HemangGadhvi04/48v-microgrid/hardware/results/magnetics_thermal_report.md

# Magnetics Winding and Thermal Screen

This analytical screen sizes conductor count from both current-density and DCR requirements. The stacked-core window scales with stack count and a 70% round-wire packing factor is applied. Release still requires the exact bobbin drawing, a wound sample, measured DCR, loaded inductance, and a thermal test.

| Inductor | Cores | Turns | Strands (current / DCR / selected) | Est. DCR / limit | Effective fill | Est. loss | Est. rise | Screen |
|---|---:|---:|---:|---:|---:|---:|---:|---|
| LDC | 3 | 28 | 20 / 52 / 52 | 14.87 / 15.00 mOhm | 33.1% | 3.48 W | 9.3 C | PASS |
| L1 | 2 | 19 | 23 / 34 / 34 | 11.85 / 12.00 mOhm | 22.0% | 3.75 W | 12.0 C | PASS |
| L2 | 1 | 19 | 23 / 24 / 24 | 11.70 / 12.00 mOhm | 31.1% | 3.61 W | 15.0 C | PASS |

## Result

**PRELIMINARY PASS:** the revised conductor counts satisfy the analytical DCR, effective-fill, and temperature-rise screens.
