HemangGadhvi04/48v-microgrid/docs/PROJECT_EXECUTION_STATUS.md

# Project Execution Status

Status date: 2026-09-11

Completion percentages represent verified deliverables, not elapsed calendar
time. Hardware stages carry more uncertainty than simulation and remain open
until bench evidence exists.

| Phase | Verified completion | Evidence complete | Remaining gate |
|---|---:|---|---|
| 1. Simulation foundation | 95% | All eight regression stages pass; report and plots retained | Repository release and publication |
| 2. Power electronics hardware | 60% | Testbench requirements, portable control/protection, integrated real-time application, corner/loss and sensing calculations, complete current/voltage/temperature front-end connectivity and calculated ADC ranges, manufacturer-curve-based E65 magnetic stack/turn/conductor sizing, tolerance-safe 30 mF DC-link bank, exact passive/fuse/connector candidates, contactor families, calculated bootstrap and independent PWM-disable chain, four-layer PCB current/spacing constraints, expanded BOM, reproducible KiCad capture covering 156 symbols/502 pins/132 logical nets, frozen LaunchPad allocation, host-tested ISR boundary, explicit ADC/PWM timing configuration, CPU1 peripheral initialization, and Driverlib adapter | KiCad native ERC, production symbols and footprint refinement, exact bobbin/physical magnetic validation, PCB layout, target build and timing, assembly and 500 W bench test |
| 3. Battery and grid interface | 55% | Bidirectional battery ECM, dynamic-phasor transition validation, dual-PLL application integration, grid-following/grid-forming transfer, portable droop, relay synchronization, and dual-side voltage measurement requirements | Cell characterization/BMS, switching and HIL transfer tests, grid emulator and measured transitions |
| 4. Communications and SCADA | 78% | SunSpec 1/101 schema, matching embedded C and Python endpoints, bounded 3.5-character RTU framer, coherent ISR telemetry snapshots, C2000 SCI-B/RS-485 direction binding, durable gateway, InfluxDB writer, Grafana dashboard and host tests | Target build, physical commissioning, live services, endurance/fault testing and independent conformance checks |

Approximate overall execution is now about 65%. About 35% remains, with
most remaining effort in physical design, procurement, assembly, commissioning,
and safety-controlled bench validation.

## Current verified baseline

- The MATLAB regression suite passes open-loop and closed-loop islanded
  inverter tests, LCL/grid tests, SOGI-PLL tests, grid-following tests, PV and
  MPPT tests, and the coupled solar-to-grid energy-balance test.
- The portable C firmware core builds with C11 warnings treated as errors.
- Host tests verify PI anti-windup, P&O convergence, buck/boost duty bounds,
  safe startup and precharge, latched protection, SOGI-PLL tracking through a
  50 Hz to 52 Hz step, PR current control against an RL plant, utility-loss
  transfer to grid-forming PWM, breaker isolation, synchronization, and
  qualified reconnection.
- The C2000 configuration now freezes and checks a 100 MHz ePWM clock,
  center-aligned 20 kHz `TBPRD=2500`, 100 ns/10-count dead band, three-module
  eight-channel ADC SOC schedule, 200 ns acquisition windows, and a calculated
  1.68 us coherent conversion-set time. Physical target timing remains open.
- Manufacturer curve fits now give electrically feasible 40-permeability Kool
  Mu HF E65 references: 3 cores/28 turns for LDC, 2/19 for L1, and 1/19 for L2,
  all at or below 0.199 T predicted peak flux. Window and thermal proof remain
  open before these become released winding designs.
- Three KEMET ALS31A103KE100 capacitors now form the reference DC-link bank.
  Even at -20% tolerance it provides 24 mF, predicts 1.23 V peak-to-peak ripple,
  and has 4.6 times the calculated 100 Hz ripple-current requirement. The
  30 mF value passes the complete eight-stage MATLAB simulation regression.
- The gate-drive chain now uses the UCC27211A internal bootstrap diode, a
  checked 100 nF capacitor, and a discrete four-term safety enable applied to
  all eight PWM inputs. Conservative margins are 1.75 V above bootstrap UVLO,
  83 ns effective dead time, and 85 ns maximum asynchronous disable latency.
- A native KiCad project now captures every row of the checked connectivity
  model with embedded project symbols. Its deterministic generator and
  independent verifier prove exact coverage; KiCad's own ERC remains pending
  until the local tool installation completes.
- U6-U8 are frozen to TMCS1123B2AQDVGRQ1. The 30 A hardware threshold uses a
  0.600 V VOC setting; calculated sensor-conductor loss is 0.210 W worst case.
  The source schematic now includes VS, GND, VREF, VOC, OC, ALERT and NC pins,
  threshold dividers, 10 uF threshold stabilization, and local supply bypassing.
- PV and DC-bus sensing now use calculated OPA320-Q1 live-zero divider stages;
  PCC and utility sensing use AMC3330-Q1 isolated amplifiers with OPA320-Q1
  ADC drivers; heatsink temperature uses TMP235-Q1. All eight nominal ADC
  ranges pass the 0.1 V to 3.2 V design-margin test.
- The PCB baseline is four layers with 70 micrometre outer copper, 12 mm DC and
  6 mm AC power paths, explicit analog/switch-node separation, and no reliance
  on vias as the primary high-current path.

## Immediate execution sequence

The project has transitioned to a rigorous 10-Gate hardware transition framework. The immediate next steps are:

1. **Gate 1B-1D (Pending User Action):** Perform physical target compilation in TI Code Composer Studio (CCS), flash the F28379D LaunchPad, and verify deterministic ADC/PWM/ISR timing and hardware Trip Zone functionality via oscilloscope.
2. **Gate 2 (Magnetics Redesign):** Redesign the E65 Kool Mµ inductors (more parallel strands, larger cores, or different topology) to resolve the DCR limit failures (LDC currently 38.67 mΩ > 15 mΩ).
3. **Gate 2 (Electrical Design):** Complete the semiconductor loss models, select final unresolved analog frontend ICs (buffers/isolation amplifiers), and freeze the Gate 2 electrical schematic.
4. **Gate 3-10:** Proceed sequentially through PCB layout, low-voltage bring-up, and staged power testing up to 500 W.
