HemangGadhvi04/48v-microgrid/docs/IMPLEMENTATION_PLAN_10_GATES.md

# Complete 48V Microgrid Execution Plan (Revised 10-Gate System)

This plan details the sequence of engineering gates to close the remaining 38% of the project. It introduces strict milestones to minimize risk, transitioning the validated mathematical models and generated schematics into a physical, tested 500W prototype.

## User Review Required

> [!WARNING]
> **Toolchain & Licensing:** We will need access to a KiCad 8.x installation for PCB layout and Texas Instruments Code Composer Studio (CCS) with C2000Ware for physical firmware compilation.
> 
> **Hardware Lab Safety:** Stage 6 involves live 48V DC and AC mains-equivalent test voltages. Safe bench procedures, current-limited lab supplies, and a grid emulator / programmable AC source are mandatory for physical execution.
>
> **Formal Professor Reviews:** 
> 1. Pre-Fabrication (Gate 4)
> 2. Pre-Power (Gate 6)
> 3. Pre-Grid Emulator (Gate 7)

## Open Questions

> [!IMPORTANT]
> 1. **Hardware Sourcing:** Are we sending the PCB out for PCBA (assembly) or assembling the prototype in-house? This changes how we output manufacturing files.
> 2. **Grid Emulator:** Do we have access to a physical AC grid emulator/source for Phase 3 testing, or will we rely on resistive/RL dummy loads for initial inverter validation?

## Gate Execution Sequence

### Gate 0 — Freeze the Hardware/Firmware Contract
- [x] Create `docs/hardware_firmware_interface.md`
- [x] Freeze PWM, ADC, GPIO mapping and polarities

### Gate 1 — Real C2000 Target Build
- **1A. Toolchain**: Setup `c2000_port` modular file structure.
- **1B. Bring-up firmware**: Skeletal implementation testing clock → GPIO → PWM → ADC → ISR → TZ → SCI.
- **1C. ISR Profiling**: Measure execution time (Budget < 35 μs).
- **1D. Hardware shutdown path**: Time sensor → comparator → trip → ePWM disable chain physically.

### Gate 2 — Final Electrical Design
- **2A. Power architecture**: Document worst-case maximums and transients.
- **2B. Semiconductor review**: Conduction/switching loss tables for FETs.
- **2C. Gate-drive review**: CMTI, isolation, dead-time margins, bootstrap behavior.
- **2D. Sensor design**: Analog filter and ADC scaling design.
- **2E. Protection architecture**: Centralized fault matrix.
- **2F. Magnetics**: Thermal and window fill calculation verification.

### Gate 3 — PCB Design
- **Stackup**: Define KiCad net classes, trace widths (based on IPC-2152), and 4-layer allocations.
- **Critical Loops**: Isolate high di/dt and switch nodes from TMCS1123 sensing zones.

### Gate 4 — Pre-Fabrication Design Review (PROFESSOR CHECK 1)
- **Review**: Schematic ERC, PCB DRC, footprints, orientation.
- **Deliverable**: Generate Fab package (Gerbers, BOM, etc.).

### Gate 5 — Board Bring-Up
- **5A. Unpowered inspection**: Resistance checks to ground on all rails.
- **5B. Control power only**: 15V, 5V, 3.3V bias verification.
- **5C. PWM without power**: Validate dead-time via oscilloscope.

### Gate 6 — Progressive Power Testing (PROFESSOR CHECK 2)
- **6A. DC/DC First**: 0 to 500W open loop to closed loop tests. Validate thermal limits.
- **6B. Inverter Standalone**: Islanded voltage control into resistive load up to 500W. 250→500W load step validation.

### Gate 7 — Physical Grid Interface (PROFESSOR CHECK 3)
- **7A. PLL test**: Lock and tracking to grid emulator (49Hz - 51Hz sweep).
- **7B. Breaker synchronization**: Zero-power phase-match closing test.
- **7C. Grid-following**: 0W to 500W physical export.

### Gate 8 — Microgrid Intelligence
- **State transitions**: Verify seamless Grid-following → Grid-forming behavior upon grid loss. 

### Gate 9 — Communications and Telemetry
- **Gateway**: Run Python gateway against the physical target RS-485 via SCI-B.
- **24-hour Soak**: Monitor for fault flags, CRC errors, and thermal drift over a continuous 24h run.

### Gate 10 — Final Verification and Release
- Create the final benchmark matrix mapping Simulation vs Hardware vs Difference.
- Complete documentation and repository release.
