HemangGadhvi04/48v-microgrid/docs/archive/conversation_backup.md

# Complete Conversation Backup Archive

## 1. Full Project Overview

### Main Objective

Build a **48V Open-Source Microgrid Research Platform** at approximately **500W scale**, suitable for lab-bench research and portfolio development.

### Core Purpose

To help Hemang, a BTech student in **Sustainable Energy Technologies**, develop industry-relevant skills in:

* grid-interactive inverter design
* grid-code compliance
* power electronics
* PLL synchronization
* LCL filter design
* PV modeling
* battery-grid integration
* droop control
* islanding/seamless transfer
* SunSpec Modbus communication
* dashboard-based monitoring

The uploaded roadmap frames this as a project focused on **Grid Code Compliance**, described as a valuable skill for companies such as Sterling & Wilson, Tata Power Solar, Fluence, GE Vernova, and Delta Electronics. 

### Original Problem

Hemang asked for a **step-by-step approach** to build the project.

### Evolution of Discussion

The conversation evolved as follows:

1. User shared the project concept.
2. Assistant converted the concept into a practical phased execution roadmap.
3. User agreed and asked to continue.
4. Assistant created a detailed **3-month weekly plan**.
5. User now requests a complete backup/archive of the whole conversation.

### Current Status

The project is currently at the **planning and roadmap stage**. No actual simulation, code, hardware design, or testing has been completed in the conversation.

---

# 2. Complete Timeline

## Stage 1: Project Introduced

User stated:

* “I want to build this project.”
* Identified himself as **Hemang**.
* Mentioned he is doing **BTech in Sustainable Energy Technologies**.
* Asked for a step-by-step approach.

## Stage 2: Uploaded Project Roadmap

The uploaded text described:

* Project title: **The 48V Open-Source Microgrid Research Platform**
* Scale: **500W**
* Value proposition: **Grid Code Compliance**
* Four phases:

  * Simulation-only foundation
  * Power electronics hardware
  * Battery and grid interface
  * Communication layer

## Stage 3: First Assistant Response

Assistant converted the roadmap into a practical execution approach:

* Start with simulation.
* Avoid hardware first.
* Build inverter simulation.
* Add LC and then LCL filter.
* Implement PLL.
* Model PV using single diode model.
* Move later to C2000, GaN/SiC, PCB, battery, droop control, and Modbus.

## Stage 4: User Asked to Continue

User replied: “yup go on.”

## Stage 5: Second Assistant Response

Assistant produced a **3-month weekly execution plan**, covering:

* Month 1: fundamentals and inverter simulation
* Month 2: grid connection, LCL filter, PLL
* Month 3: PV model, MPPT, full solar-grid simulation, documentation

## Stage 6: Current Request

User asked for a complete archive of the conversation.

---

# 3. All Ideas

## Accepted Ideas

These were treated as core project directions:

* Build a **48V, 500W microgrid research platform**.
* Begin with **simulation only**.
* Use **MATLAB/Simulink + Simscape Electrical**.
* Model a **single-phase grid-following inverter**.
* Design and compare **LC and LCL filters**.
* Implement a **PLL**.
* Create a **single-diode PV model manually**.
* Use GitHub for documentation.
* Later use **TI C2000 LaunchPad TMS320F28379D**.
* Use **GaN or SiC devices** for advanced hardware.
* Design a proper PCB instead of jumper wiring.
* Implement **droop control**.
* Study **seamless transfer/islanding detection**.
* Add **SunSpec Modbus over RS-485**.
* Use **Python + Raspberry Pi + InfluxDB + Grafana** for monitoring.

## Rejected or Discouraged Ideas

The roadmap and assistant discouraged:

* Starting directly with hardware.
* Using ESP32 and MOSFETs on a breadboard for the serious version.
* Connecting to the real grid early.
* Copying ready-made PV library blocks blindly.
* Skipping PLL.
* Skipping documentation.
* Treating the project like a hobby build rather than applied research.

## Alternative Approaches

For grid simulation/testing:

* **Option A:** Use a programmable AC source from the lab.
* **Option B:** Build a second inverter as a grid emulator for PHIL-style testing.

For first hardware progression:

* Instead of jumping directly to full inverter hardware, first build a **synchronous buck-boost converter**.

---

# 4. Technical Content

## Architecture

### Final Intended System

A 48V microgrid research platform containing:

* solar PV source
* DC-DC converter
* DC link
* battery interface
* single-phase inverter
* LCL filter
* grid interface or grid emulator
* controller
* communication layer
* monitoring dashboard

## Main Subsystems

### 1. PV Subsystem

* Uses single diode model.
* Should include irradiance and temperature variation.
* Should generate I-V and P-V curves.

### 2. DC-DC Converter

* Suggested topology: synchronous buck-boost.
* Controlled using digital PI control.
* Eventually implemented on C2000.

### 3. DC-AC Inverter

* Single-phase H-bridge inverter.
* Uses PWM/SPWM.
* Later grid-following control.

### 4. Output Filter

* Start with LC filter.
* Upgrade to LCL filter.
* Study damping and resonance.

### 5. Grid Synchronization

* Implement PLL.
* Goal: track 50 Hz grid phase and frequency even with distortion.

### 6. Battery/Grid Interface

* Later add current-control and voltage-control modes.
* Implement seamless transfer during islanding.

### 7. Communication Layer

* SunSpec Modbus over RS-485.
* Raspberry Pi polls data.
* Data logged to InfluxDB.
* Dashboard built in Grafana.

---

## Algorithms Mentioned

### PLL

Purpose:

* Track grid voltage phase.
* Estimate grid frequency.
* Synchronize inverter current injection.

### Digital PI Controller

Purpose:

* Regulate converter output.
* Control voltage or current loops.

### MPPT

Suggested first method:

* Perturb and Observe.

Purpose:

* Extract maximum power from PV source.

### Droop Control

Two forms mentioned:

* **P-f droop**
* **Q-V droop**

Purpose:

* Autonomous microgrid operation.
* Load sharing and frequency/voltage regulation.

### Islanding/Seamless Transfer Logic

Goal:

* Detect grid outage.
* Switch from current-control mode to voltage-control mode without disturbing the load.

---

## Equations

No explicit equations were written in the conversation.

However, technical equation areas were identified:

* single diode PV equation
* LCL resonance frequency
* PI controller equation
* power equations for P and Q
* droop control equations
* PLL phase/frequency estimation

Specific formulas were not provided.

---

## Code Snippets

No code snippets were discussed or written.

Future code areas identified:

* MATLAB/Simulink models
* C code for C2000 digital PI controller
* Python code using `pymodbus`
* InfluxDB/Grafana integration scripts

---

# 5. Information Extracted

## Facts from Uploaded Project Text

* Project name: **48V Open-Source Microgrid Research Platform**
* Scale: **500W**
* Phase 1 tool: **MATLAB/Simulink + Simscape Electrical**
* First target: **single-phase grid-following inverter**
* Key skill: **LCL filter design**
* Key control element: **PLL**
* PV task: manually code **single diode model**
* Hardware controller: **Texas Instruments C2000 LaunchPad TMS320F28379D**
* Advanced switches: **GaN FETs or SiC MOSFETs**
* PCB tools: **KiCad or Altium**
* Later algorithm: **droop control**
* Communication: **SunSpec Modbus over RS-485**
* Monitoring stack: **Python, Raspberry Pi, InfluxDB, Grafana** 

## Recommendations Given

* Start simulation-first.
* Do not touch hardware initially.
* Use GitHub from the beginning.
* Document every milestone.
* Build small subsystems before integrating the full platform.
* Start hardware with DC-DC converter before inverter.
* Avoid real-grid connection until much later and only with lab supervision.

---

# 6. Questions and Answers

## Q1: User asked

“How should I build this project step by step?”

### Answer

Use a phased approach:

1. Simulation foundation.
2. Basic inverter model.
3. LC filter.
4. LCL filter.
5. PLL.
6. PV single diode model.
7. C2000-based hardware.
8. DC-DC converter.
9. Inverter hardware.
10. Battery/grid interface.
11. Droop control.
12. Modbus and monitoring.

---

## Q2: User said

“yup go on”

### Answer

A detailed **12-week plan** was provided.

It covered:

* Week 1: big picture and setup
* Week 2: first inverter simulation
* Week 3: output filtering
* Week 4: control basics
* Week 5: LCL filter
* Week 6: simulated grid
* Week 7: PLL
* Week 8: full grid-following inverter
* Week 9: PV model
* Week 10: MPPT
* Week 11: solar-grid integration
* Week 12: documentation and portfolio

---

# 7. Decisions

## Decision 1: Start with simulation

### Why

Safe, low-cost, and builds real understanding before hardware.

## Decision 2: Use MATLAB/Simulink first

### Why

It is suitable for power electronics, control systems, and grid simulation.

## Decision 3: Learn LC first, then LCL

### Why

LC helps understand basic filtering; LCL is more industry-relevant for grid-tied inverters.

## Decision 4: Implement PLL

### Why

Grid synchronization is central to grid-following inverter operation.

## Decision 5: Delay hardware

### Why

Hardware is risky without validated models and control understanding.

## Decision 6: Use C2000 later

### Why

It is industry-relevant for inverter and converter control.

## Decision 7: Build DC-DC converter before full inverter hardware

### Why

It is safer and easier to debug than a complete grid-interactive inverter.

## Decision 8: Use GitHub and documentation from day one

### Why

The project is intended to become a portfolio and research asset.

---

# 8. Project Assets

## Main Roadmap

### Phase 1: Simulation

* MATLAB/Simulink
* single-phase inverter
* LCL filter
* PLL
* PV model
* grid injection simulation

### Phase 2: Power Electronics Hardware

* C2000 LaunchPad
* GaN/SiC switches
* buck-boost converter
* digital PI controller
* custom PCB

### Phase 3: Battery and Grid Interface

* grid simulator or second inverter
* back-to-back setup
* droop control
* islanding
* seamless transfer

### Phase 4: Communication

* SunSpec Modbus
* RS-485
* Raspberry Pi
* Python
* InfluxDB
* Grafana

---

## 3-Month Weekly Plan

### Month 1

* Week 1: understand project and install tools
* Week 2: build first inverter simulation
* Week 3: add LC filter
* Week 4: learn PI control

### Month 2

* Week 5: design LCL filter
* Week 6: create simulated grid
* Week 7: implement PLL
* Week 8: build full grid-following inverter simulation

### Month 3

* Week 9: build PV model
* Week 10: implement MPPT
* Week 11: integrate solar with grid inverter
* Week 12: document, organize GitHub, prepare portfolio material

---

## First Week Checklist

* Install MATLAB/Simulink.
* Create GitHub repo.
* Study inverter fundamentals.
* Build basic H-bridge.
* Learn SPWM.
* Simulate AC waveform.
* Add LC filter.
* Document everything.

---

## Expected 3-Month Outputs

* inverter simulation
* LC and LCL filter comparison
* PLL subsystem
* PV model
* MPPT simulation
* grid-following inverter simulation
* GitHub repository
* screenshots
* technical documentation

---

# 9. Outstanding Work

## Not Yet Done

* No MATLAB model has been created in-chat.
* No Simulink file exists yet.
* No code has been written.
* No component list has been finalized.
* No PCB has been designed.
* No controller has been programmed.
* No hardware has been tested.
* No GitHub repo link has been provided.
* No equations have been derived yet.
* No literature review has been done in the conversation.

## Open Questions

* What semester/year is Hemang currently in?
* Does Hemang have MATLAB access?
* Does his lab have a programmable AC source?
* What budget is available?
* Does he have access to C2000 hardware?
* Should the first simulation use scaled AC voltage or full 230V equivalent?
* What exact PV panel specifications should be modeled?
* What battery chemistry should be used later?
* What switching frequency should be selected?
* What power level should the first hardware prototype use?
* Should the first PCB be buck, boost, buck-boost, or inverter?

## Suggested Next Steps

1. Create project folder and GitHub repo.
2. Install MATLAB/Simulink.
3. Build a basic 48V H-bridge inverter model.
4. Add SPWM.
5. Add LC filter.
6. Document waveforms.
7. Then move to LCL filter design.

---

# 10. Final Knowledge Base

## Project Name

**48V Open-Source Microgrid Research Platform**

## Student

**Hemang**

## Academic Background

BTech in **Sustainable Energy Technologies**

## Project Scale

Approximately **500W**

## Primary Goal

Create an industry-relevant microgrid research platform focused on grid-interactive inverter control and grid compliance.

## Core Learning Areas

* power electronics
* control systems
* solar PV
* battery systems
* grid synchronization
* microgrid control
* embedded systems
* PCB design
* communication protocols
* data logging

## Recommended Tools

* MATLAB
* Simulink
* Simscape Electrical
* GitHub
* Code Composer Studio
* KiCad
* Python
* Raspberry Pi
* InfluxDB
* Grafana

## Recommended Hardware Later

* TI C2000 LaunchPad TMS320F28379D
* GaN FETs or SiC MOSFETs
* custom 4-layer PCB
* current sensors
* gate drivers
* DC bus capacitors
* inductors
* battery pack
* RS-485 interface

## Key Technical Milestones

1. Simulate inverter.
2. Add LC filter.
3. Upgrade to LCL filter.
4. Implement PLL.
5. Model solar PV.
6. Implement MPPT.
7. Inject sinusoidal current into simulated grid.
8. Build DC-DC converter hardware.
9. Build inverter hardware.
10. Add battery interface.
11. Implement droop control.
12. Demonstrate islanding/seamless transfer.
13. Add Modbus and dashboard.

## Confirmed Conclusions

* Simulation should come first.
* Hardware should be delayed until models and controls are understood.
* LCL filter and PLL are high-value skills.
* C2000 is more appropriate than hobby microcontrollers for serious inverter control.
* GitHub documentation is essential.
* Real-grid connection should not be attempted early.

## Tentative Ideas

* Use lab programmable AC source if available.
* Build second inverter as grid emulator if lab equipment is unavailable.
* Use GaN or SiC devices depending on budget and availability.
* Use 18 months for full project completion.
* Use 3 months for simulation and portfolio foundation.

---

# 11. Executive Summary

Hemang, a BTech student in Sustainable Energy Technologies, wants to build a serious research-oriented project titled **“The 48V Open-Source Microgrid Research Platform.”** The project is intended to operate around the **500W scale**, making it powerful enough to run meaningful loads such as lights or fans, but still manageable for a lab environment. The main value of the project is not merely building a working circuit, but learning the deeper technical skills behind commercial solar inverters and microgrids, especially **grid code compliance**, inverter control, synchronization, and battery-grid interaction.

The original uploaded roadmap divided the project into four major phases. The first phase is a **simulation-only deep dive**, where Hemang should not touch hardware yet. This stage uses **MATLAB/Simulink and Simscape Electrical** to model a single-phase grid-following inverter. The key learning goals are to design an **LCL filter**, implement a **PLL**, and manually model a solar PV panel using the **single diode model** rather than relying on a ready-made library block. The intended output of this phase is a Simulink model showing clean sinusoidal current injection into a simulated grid.

The second phase introduces power electronics hardware. The roadmap recommends avoiding hobby-style ESP32 and breadboard MOSFET designs. Instead, it recommends using a **Texas Instruments C2000 LaunchPad**, specifically the **TMS320F28379D**, because it is widely used in industry for real-time power electronics control. It also recommends experimenting with **GaN or SiC devices**, since wide-bandgap semiconductors are increasingly important in modern energy systems. A custom PCB, preferably designed in KiCad or Altium, is recommended instead of jumper wiring. The first hardware target should be a **synchronous buck-boost converter** controlled by a digital PI controller written in C.

The third phase focuses on the battery and grid interface. Since connecting directly to the real AC grid is unsafe at this stage, the roadmap proposes either using a lab-grade programmable AC source or building a second inverter to act as a grid emulator. The advanced goal is to build two interacting inverter systems and implement **droop control**, specifically **P-f** and **Q-V droop**. A major research milestone would be demonstrating **seamless transfer**: when the grid emulator shuts off, the main inverter should switch from current-control mode to voltage-control mode without disturbing the load.

The fourth phase adds the communication layer. The roadmap recommends implementing **SunSpec Modbus over RS-485**, allowing the inverter controller to respond to queries for values like model name, AC current, voltage, power, and frequency. A **Raspberry Pi** running Python with `pymodbus` can log this information into **InfluxDB**, with visualization through **Grafana**. This makes the platform resemble a commercial inverter or microgrid monitoring system.

The assistant first converted this roadmap into a practical step-by-step strategy: start with theory and simulation, then build a basic inverter model, add filtering, implement PLL, model PV, and only later proceed to hardware. It emphasized that Hemang should not start by buying components or wiring a full system. The safest and most valuable path is simulation depth first, followed by embedded control, then hardware, then communication.

After Hemang asked to continue, the assistant produced a detailed **12-week plan**. Month 1 focuses on fundamentals: understanding microgrids, installing tools, building a basic inverter simulation, adding LC filtering, and learning PI control. Month 2 focuses on grid interaction: LCL filter design, simulated grid modeling, PLL implementation, and a complete grid-following inverter simulation. Month 3 adds solar: custom PV modeling, MPPT using Perturb and Observe, full solar-grid integration, and documentation. By the end of three months, Hemang should have a GitHub repository, Simulink models, waveform plots, a PV model, MPPT simulation, and a clear technical report.

The current status is that the project remains in planning. No models, code, PCB, hardware, or tests have been created in the conversation yet. The immediate next step is to create a GitHub repository, install MATLAB/Simulink, and build the first 48V H-bridge inverter simulation with SPWM and a simple load.
