HemangGadhvi04/48v-microgrid/simulations/inverter/results/open_loop_spectrum.png

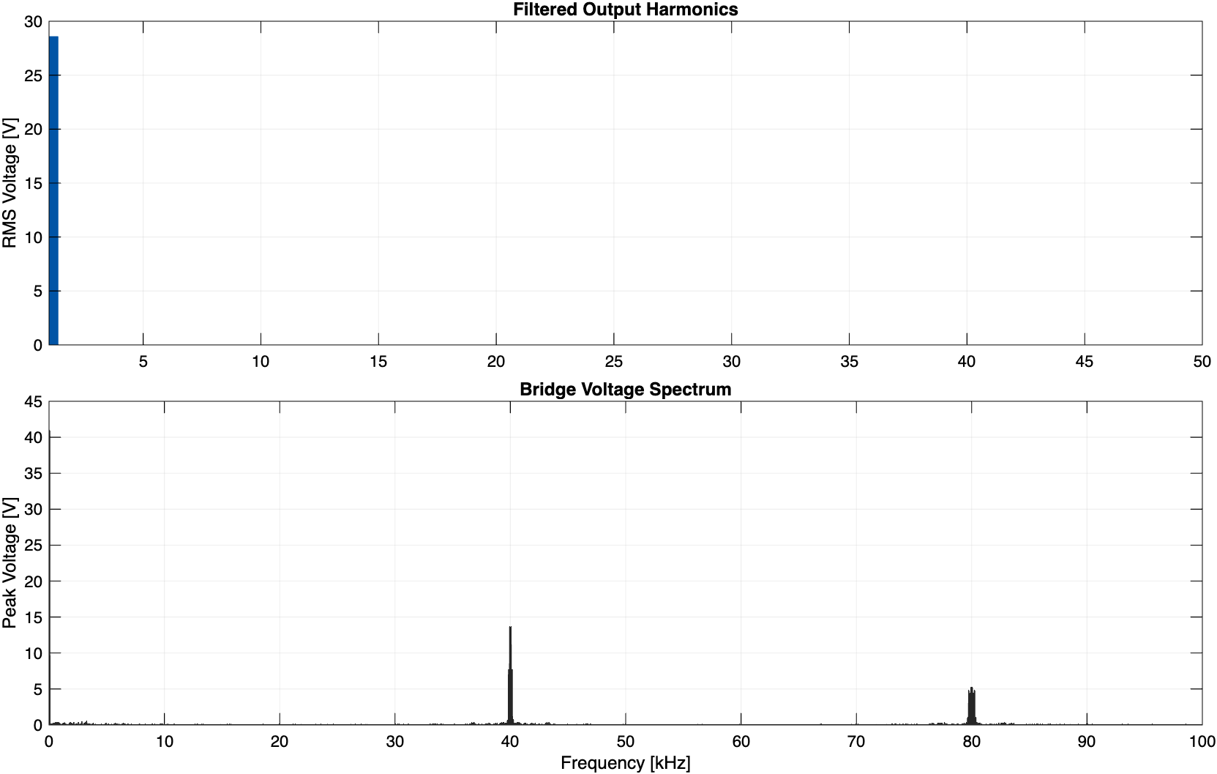
simulations/inverter/results/open_loop_spectrum.png
