HemangGadhvi04/48v-microgrid/simulations/inverter/results/closed_loop_load_step.png

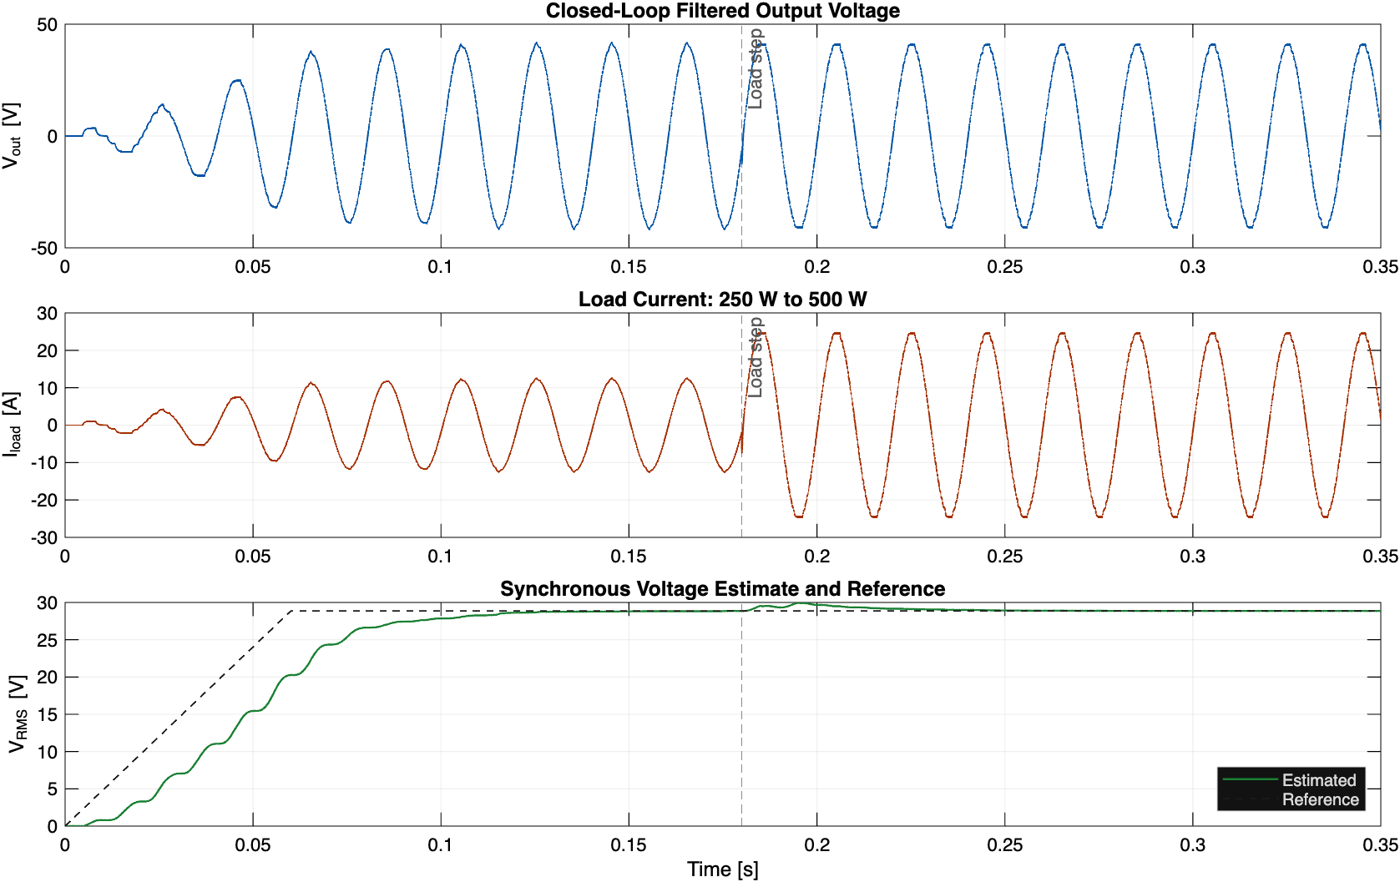
simulations/inverter/results/closed_loop_load_step.png
