HemangGadhvi04/48v-microgrid/firmware/c2000_port/driverlib_validation_report.md

# Driverlib API Validation

- Upstream: `TexasInstruments/c2000ware-core-sdk`
- Revision: `e5698c666d9ff587940d249213cbbb328a3bcd66`
- Device headers: `driverlib/f2837xd/driverlib`
- Target calls checked: 69
- Target constants checked: 65
- Missing symbols: 0

This is a header-level compatibility check. A TI C28x compiler build and a
flashed LAUNCHXL-F28379D remain required because the C28x ABI and keywords are
not compatible with the host C compiler.
