HemangGadhvi04/48v-microgrid/simulations/grid_tie/results/lcl_frequency_response.csv

frequency_hz | grid_current_gain_db_a_per_v | grid_current_phase_deg | pcc_voltage_gain
10 | 21.7803709976818 | -10.8927880167708 | 0.801226718498913
10.0481058577471 | 21.778876440503 | -10.943927034217 | 0.801121168745432
10.0964431328491 | 21.7773679912262 | -10.995294296569 | 0.801014660628873
10.1450129385591 | 21.775845525617 | -11.0468906567394 | 0.800907186007427
10.1938163934856 | 21.7743089184213 | -11.0987169684806 | 0.800798736680591
10.242854621618 | 21.7727580433587 | -11.150774086348 | 0.800689304388944
10.2921287523532 | 21.7711927731158 | -11.2030628656624 | 0.80057888081393
10.3416399205207 | 21.7696129793395 | -11.2555841624726 | 0.800467457577635
10.3913892664095 | 21.7680185326302 | -11.3083388335166 | 0.800355026242583
10.4413779357939 | 21.7664093025355 | -11.3613277361825 | 0.800241578311518
10.4916070799602 | 21.7647851575428 | -11.4145517284684 | 0.800127105227206
10.5420778557329 | 21.7631459650734 | -11.4680116689423 | 0.80001159837223
10.5927914255015 | 21.7614915914751 | -11.5217084167007 | 0.79989504906879
10.6437489572475 | 21.7598219020158 | -11.5756428313269 | 0.799777448578518
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
