HemangGadhvi04/48v-microgrid/simulations/inverter/results/closed_loop_harmonics.csv

harmonic_number | v_out_rms_v
1 | 28.8503103445016
2 | 0.00108492488607701
3 | 0.0733290672891675
4 | 0.0010600495503805
5 | 0.0756293914300266
6 | 0.00102193854861542
7 | 0.0619520919806691
8 | 0.000974520526178922
9 | 0.0470495753443478
10 | 0.000921728559775191
11 | 0.0203858858436995
12 | 0.000866867315697454
13 | 0.0580344419393793
14 | 0.000812370009070073
15 | 0.0619851943983617
16 | 0.000759833658615539
17 | 0.107710808297831
18 | 0.000710185424639751
19 | 0.0791275608074471
20 | 0.000663872698290906
21 | 0.0611169571223012
22 | 0.000621026402854773
23 | 0.00636214663160217
24 | 0.000581584302290117
25 | 0.0606293316014292
26 | 0.000545375445455674
27 | 0.100131899336221
28 | 0.000512174695333788
29 | 0.0857358305612344
30 | 0.000481737170239666
31 | 0.0218114991953767
32 | 0.000453818123572952
33 | 0.0566788695092699
34 | 0.000428183667604339
35 | 0.0750939853491827
36 | 0.000404616680252884
37 | 0.0331222369877199
38 | 0.000382918874406361
39 | 0.0315841538816862
40 | 0.000362910775079065
41 | 0.0288210772750807
42 | 0.000344431268221013
43 | 0.0329498170967764
44 | 0.000327336179786093
45 | 0.0431697330591045
46 | 0.000311496502732031
47 | 0.0289112825437176
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
