HemangGadhvi04/48v-microgrid/simulations/battery/results/battery_validation.png

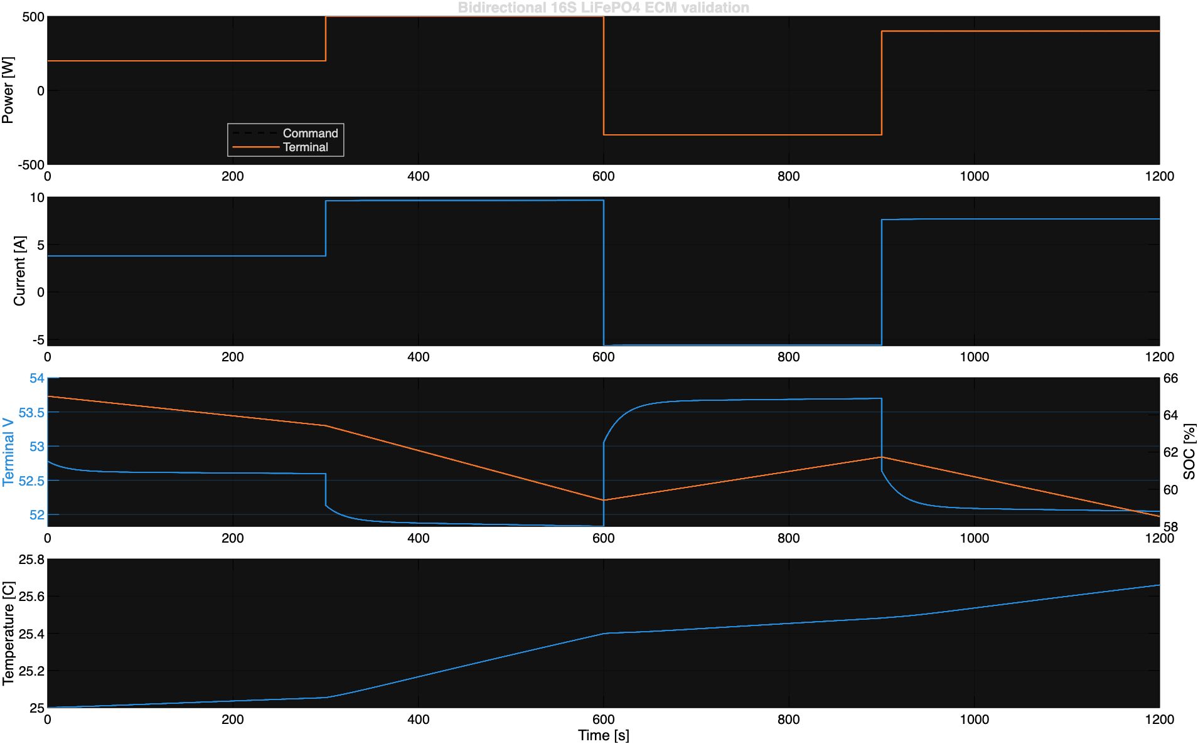
simulations/battery/results/battery_validation.png
