HemangGadhvi04/48v-microgrid/simulations/grid_sync/results/sogi_pll_validation.png

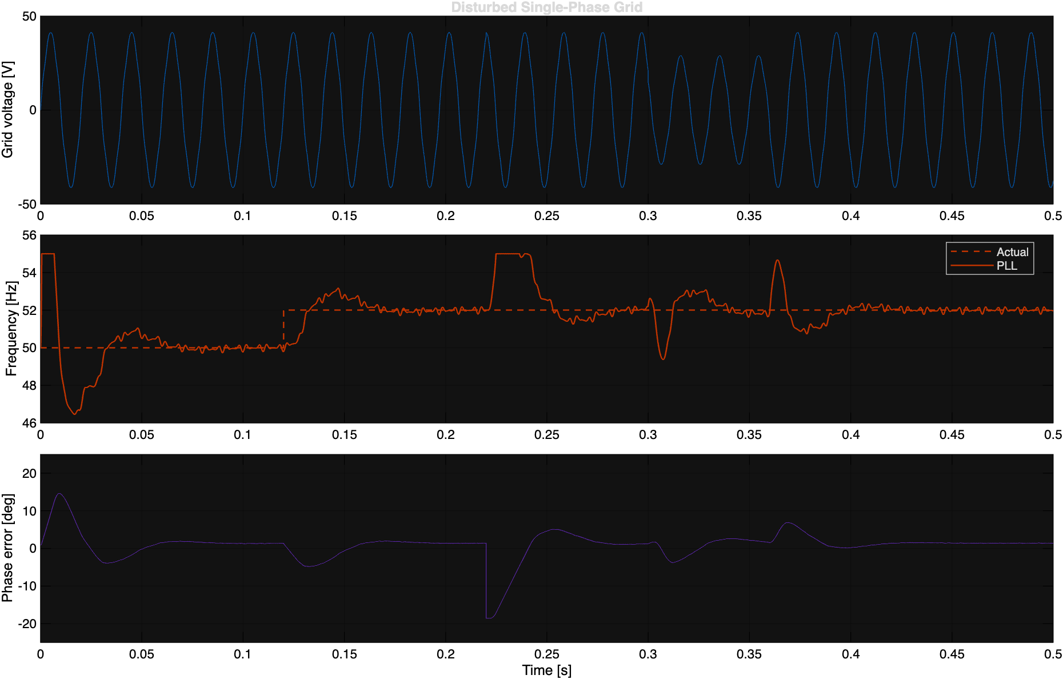
simulations/grid_sync/results/sogi_pll_validation.png
