HemangGadhvi04/48v-microgrid/simulations/grid_tie/results/grid_following_validation.png

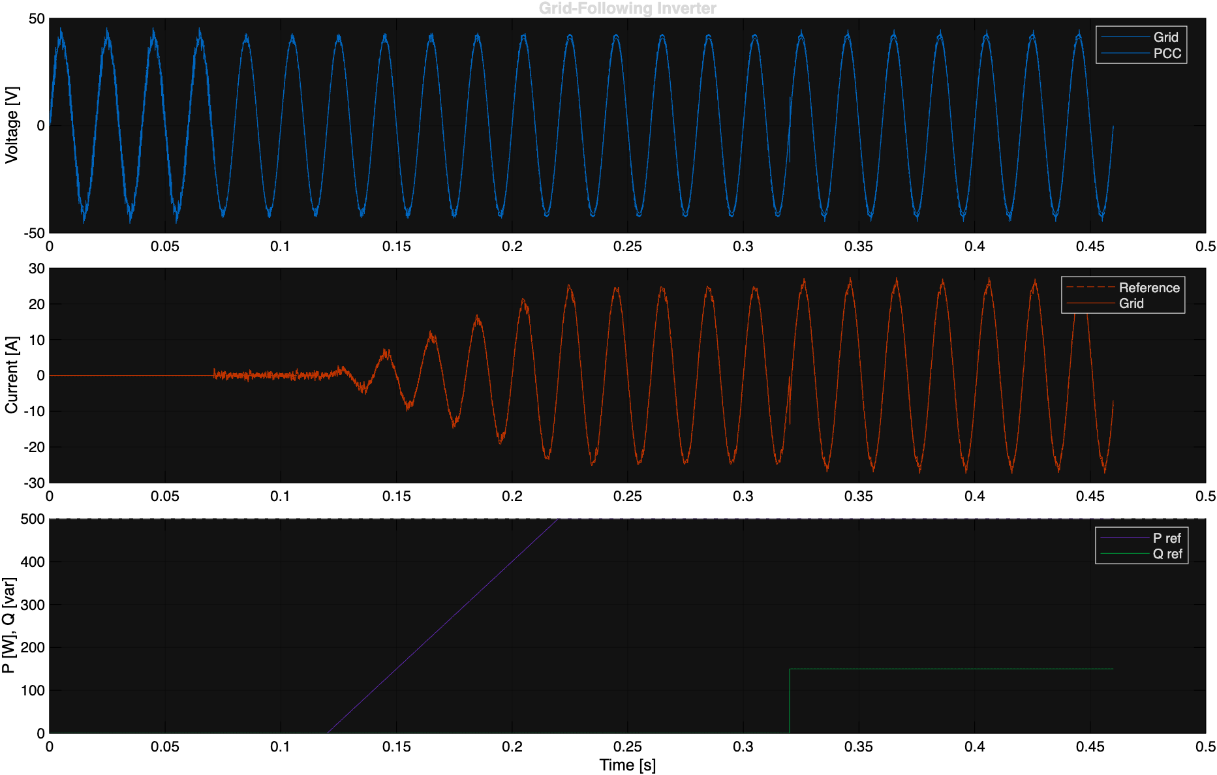
simulations/grid_tie/results/grid_following_validation.png
