HemangGadhvi04/48v-microgrid/simulations/grid_tie/results/lcl_frequency_response.png

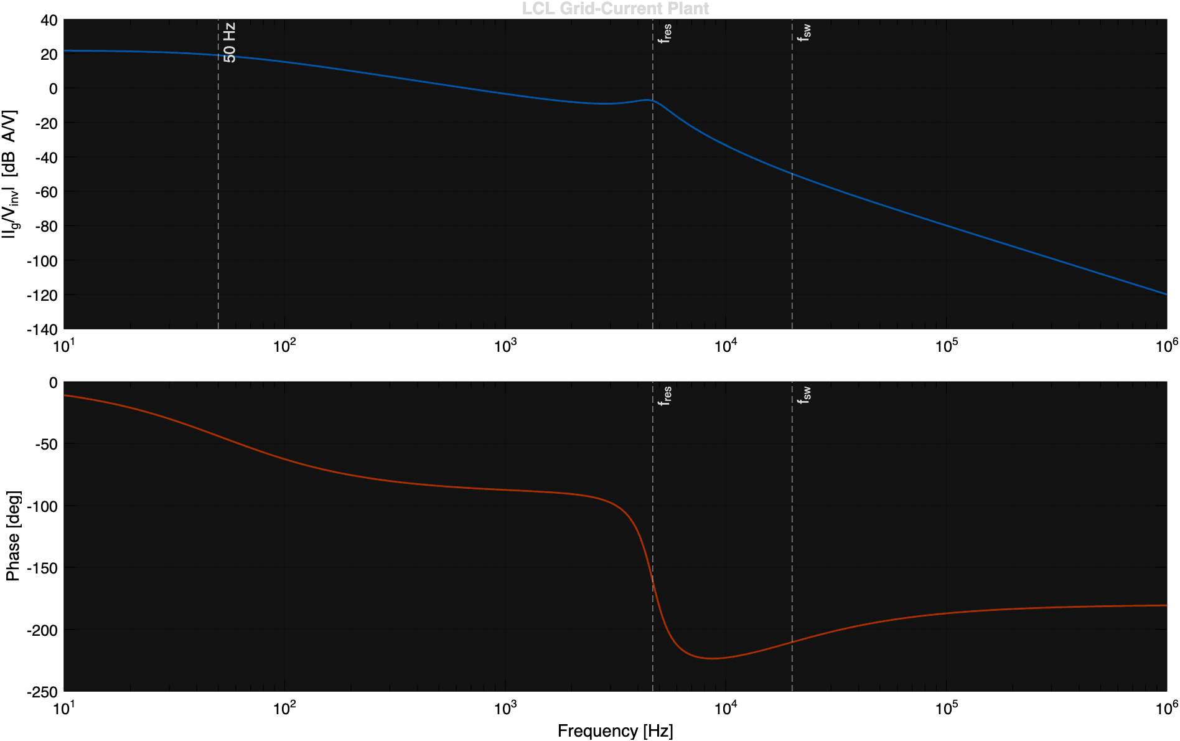
simulations/grid_tie/results/lcl_frequency_response.png
