HemangGadhvi04/48v-microgrid/simulations/grid_tie/results/lcl_grid_transient.png

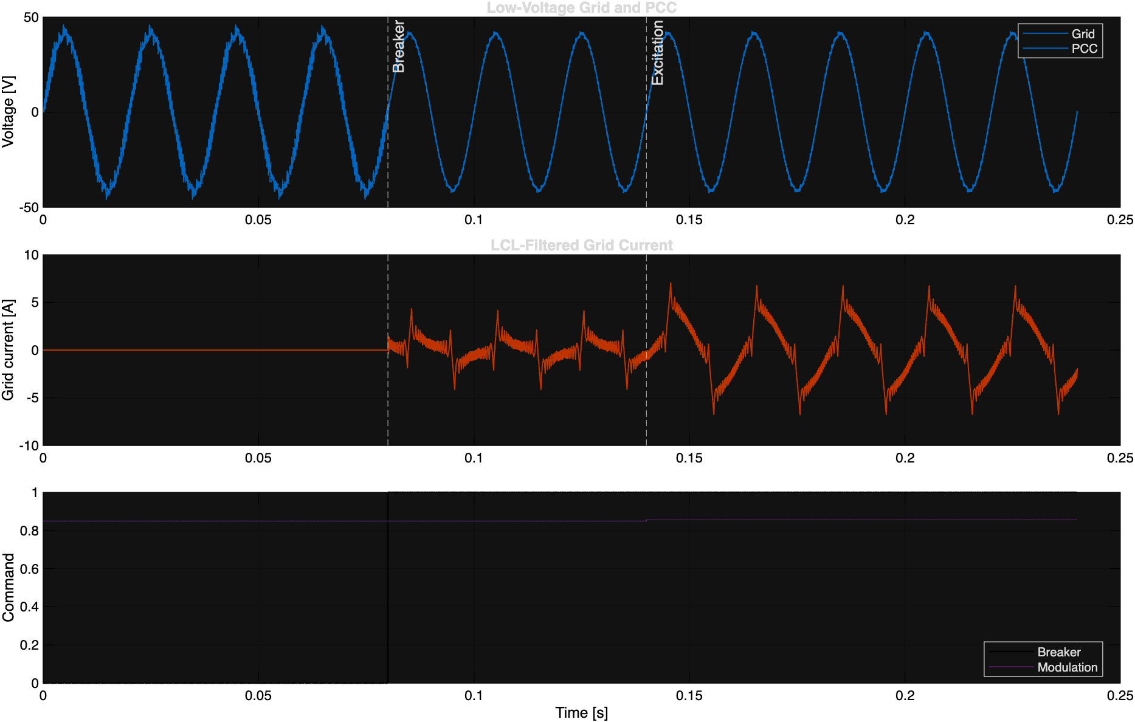
simulations/grid_tie/results/lcl_grid_transient.png
