HemangGadhvi04/48v-microgrid/simulations/inverter/results/closed_loop_regulation_detail.png

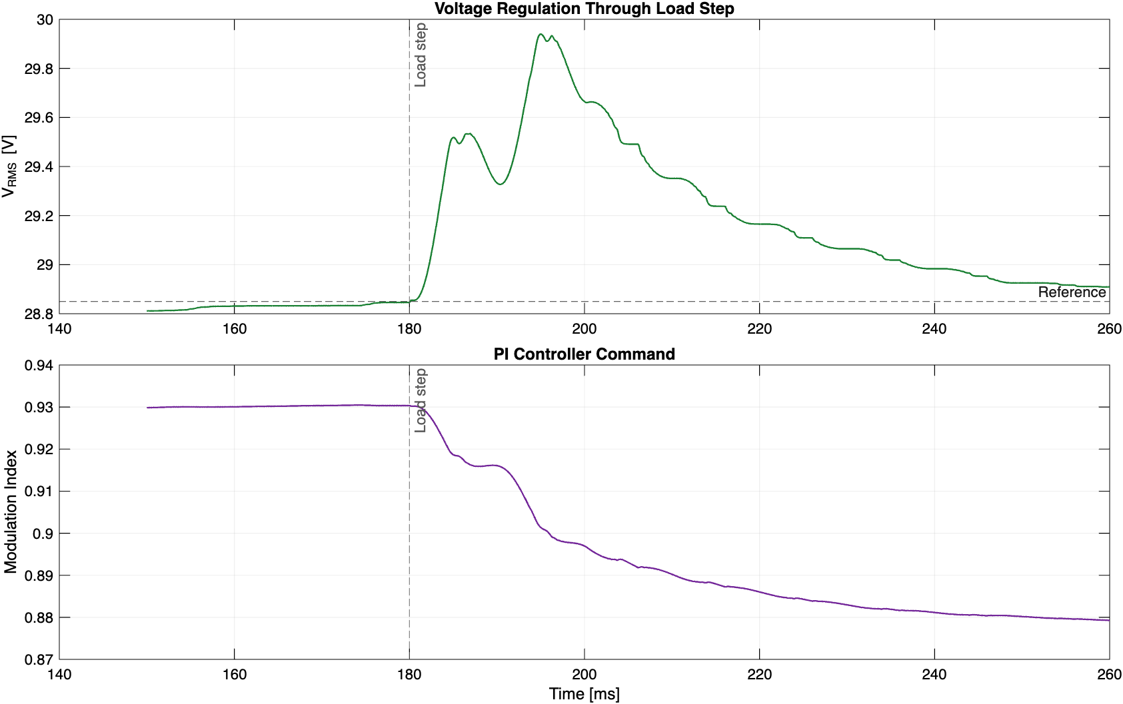
simulations/inverter/results/closed_loop_regulation_detail.png
