HemangGadhvi04/48v-microgrid/simulations/inverter/results/open_loop_switching_detail.png

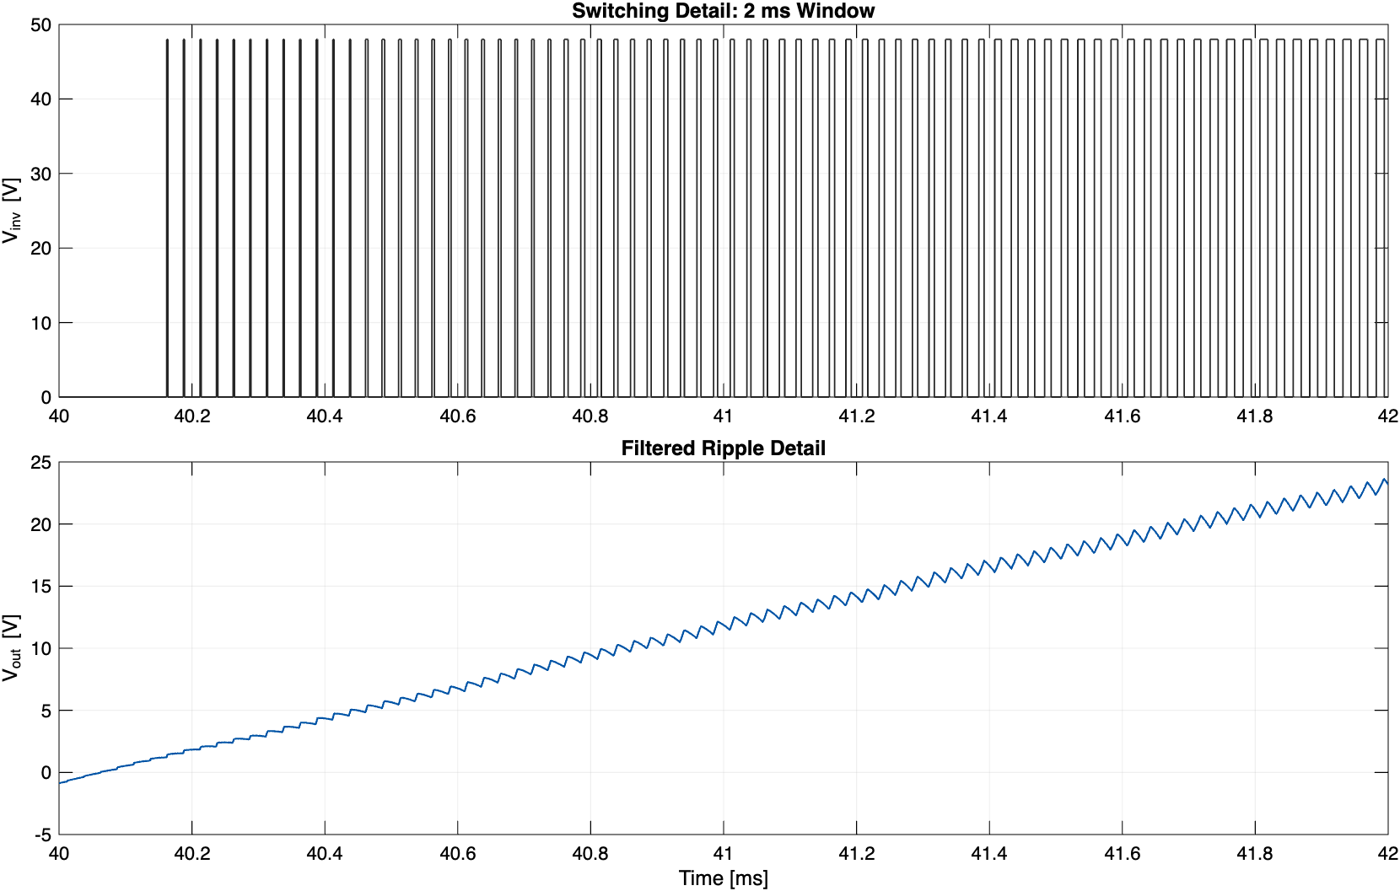
simulations/inverter/results/open_loop_switching_detail.png
