HemangGadhvi04/48v-microgrid/simulations/inverter/results/open_loop_waveforms.png

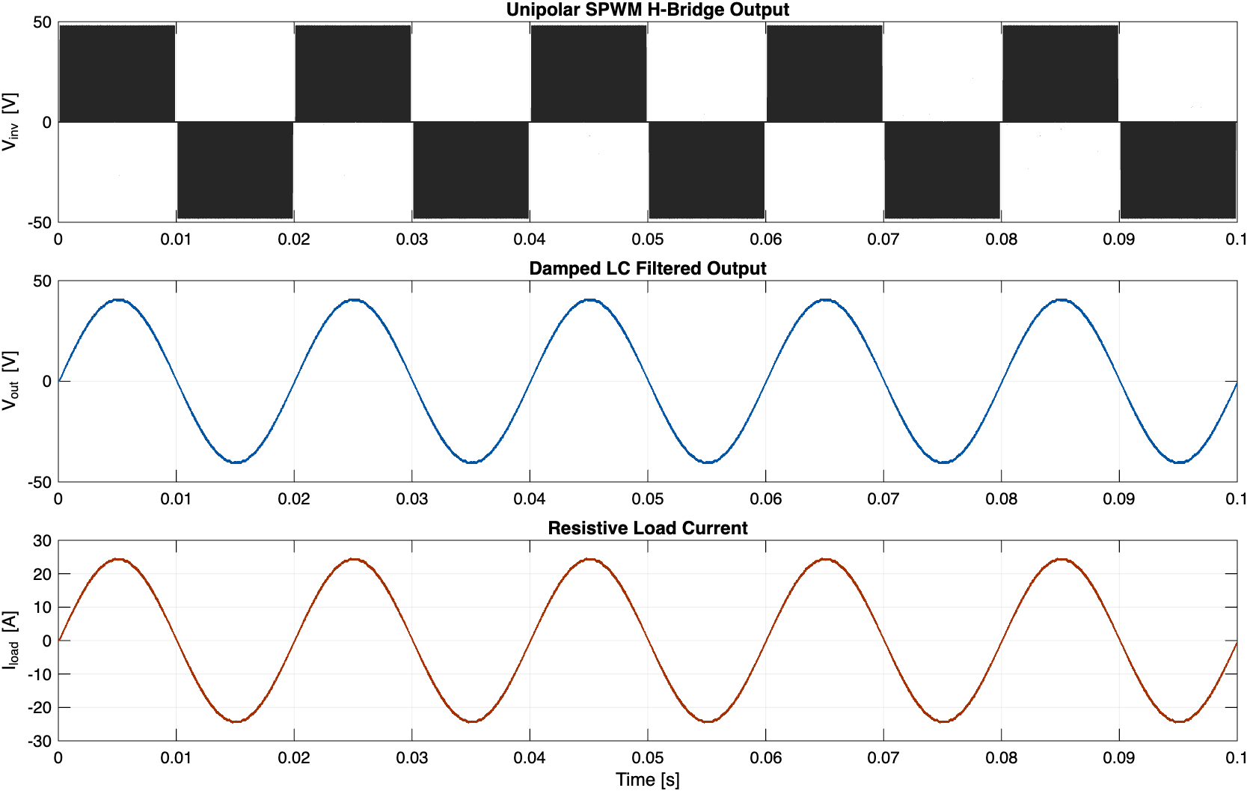
simulations/inverter/results/open_loop_waveforms.png
