HemangGadhvi04/48v-microgrid/simulations/microgrid/results/microgrid_sharing_and_current.png

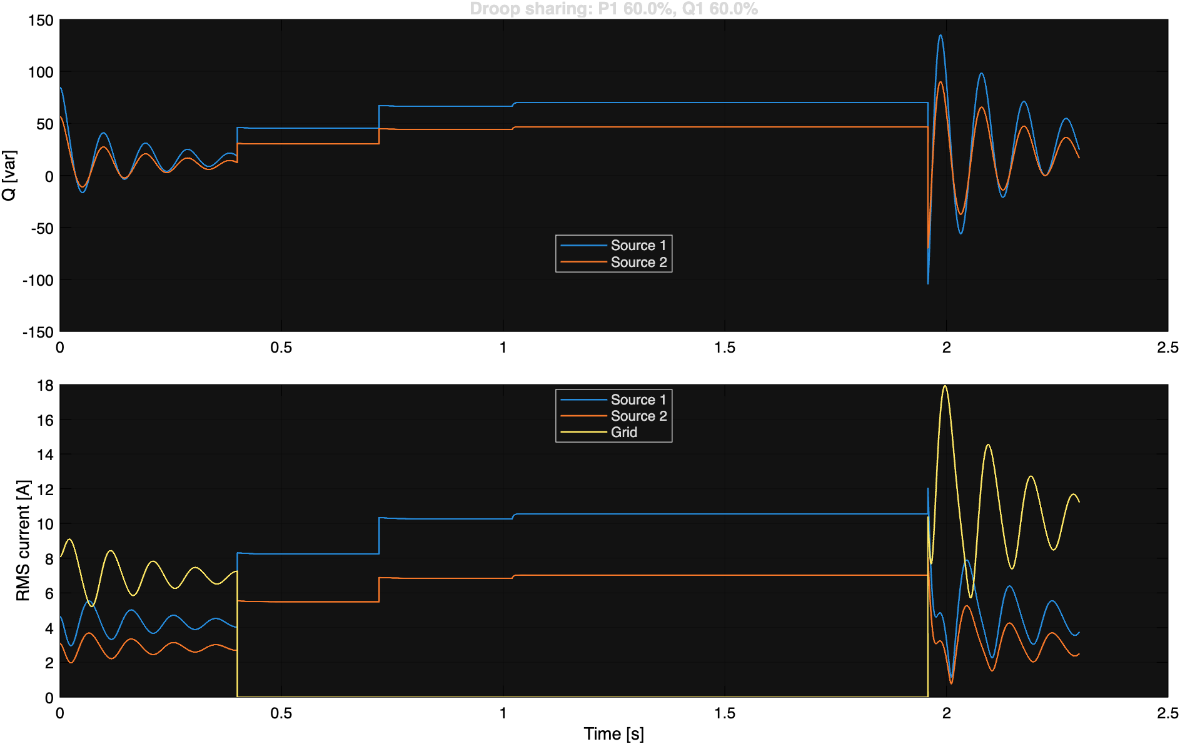
simulations/microgrid/results/microgrid_sharing_and_current.png
