HemangGadhvi04/48v-microgrid/simulations/microgrid/results/microgrid_transition.png

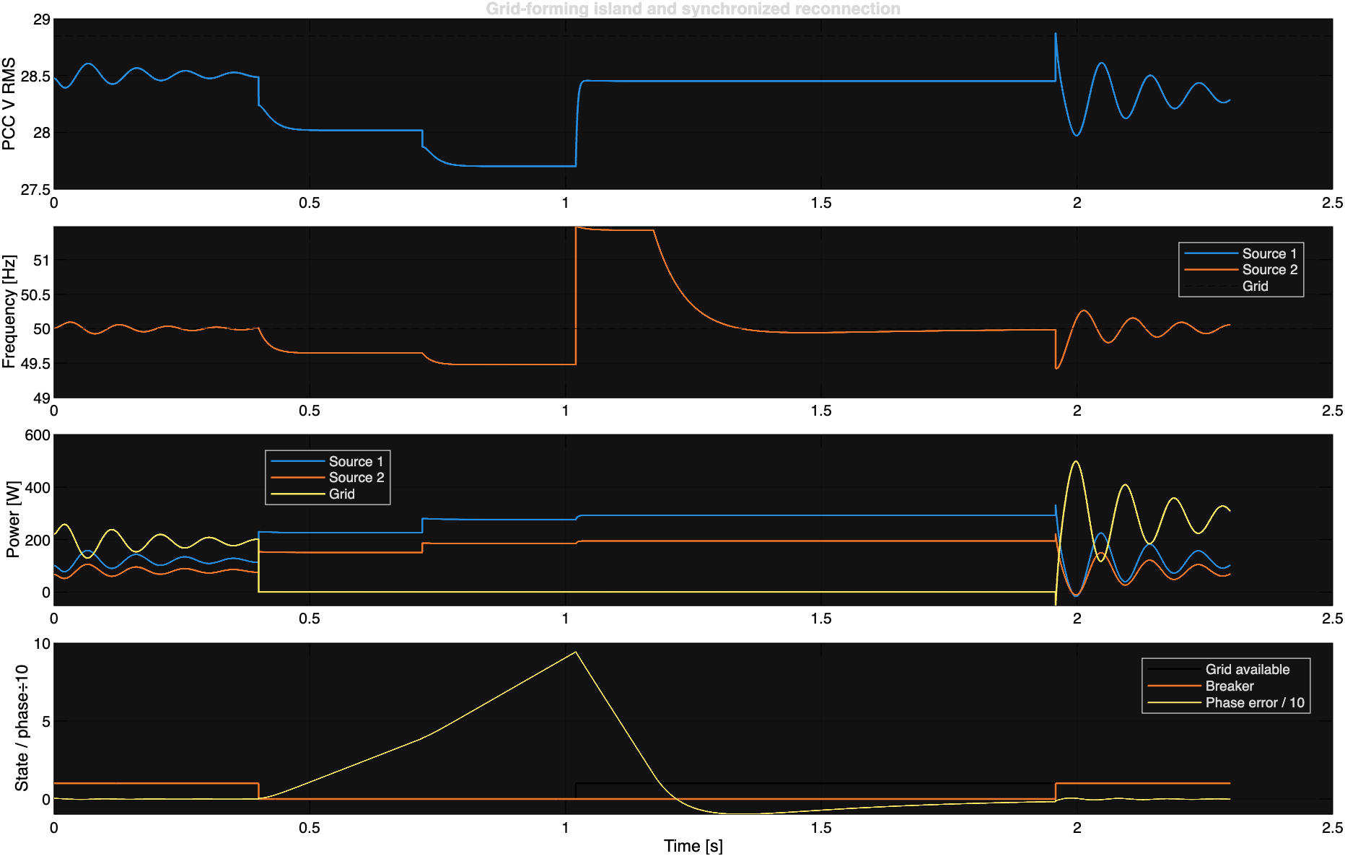
simulations/microgrid/results/microgrid_transition.png
