HemangGadhvi04/48v-microgrid/simulations/mppt/results/po_mppt_validation.png

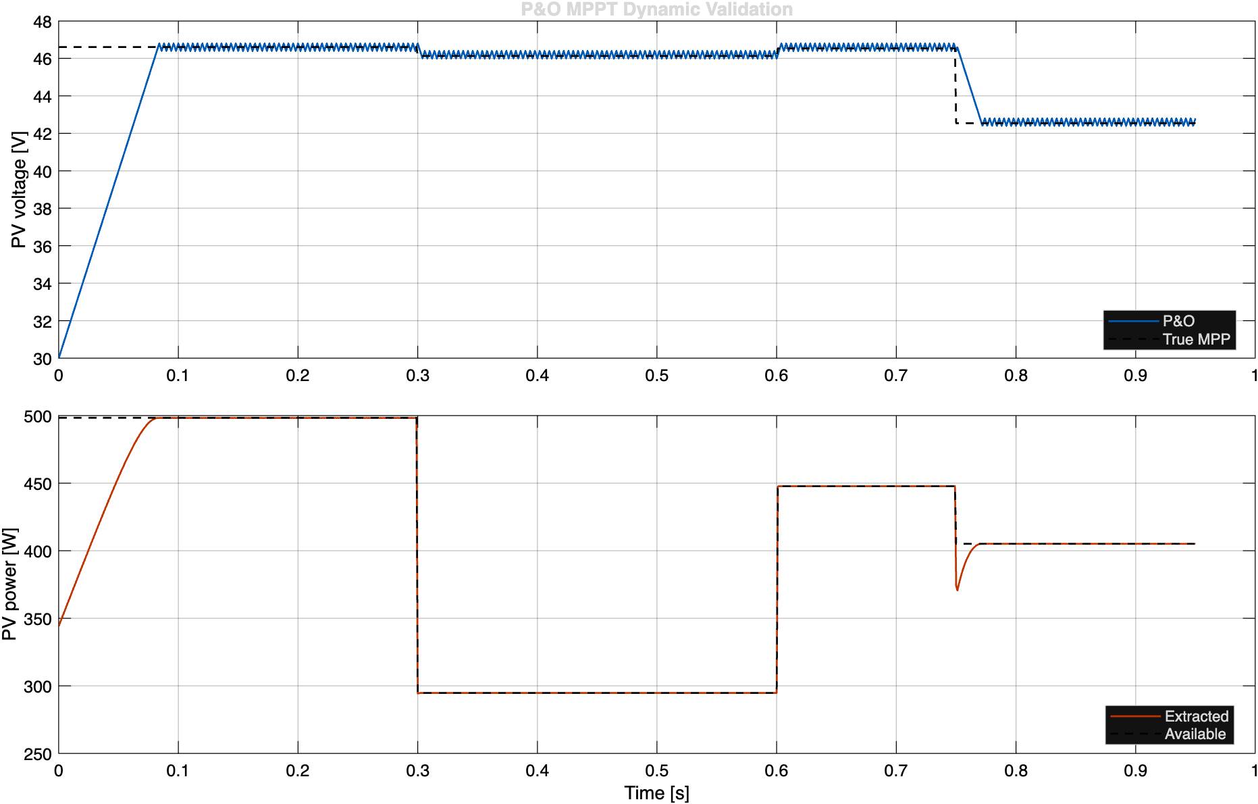
simulations/mppt/results/po_mppt_validation.png
