HemangGadhvi04/48v-microgrid/simulations/pv_model/results/pv_irradiance_curves.png

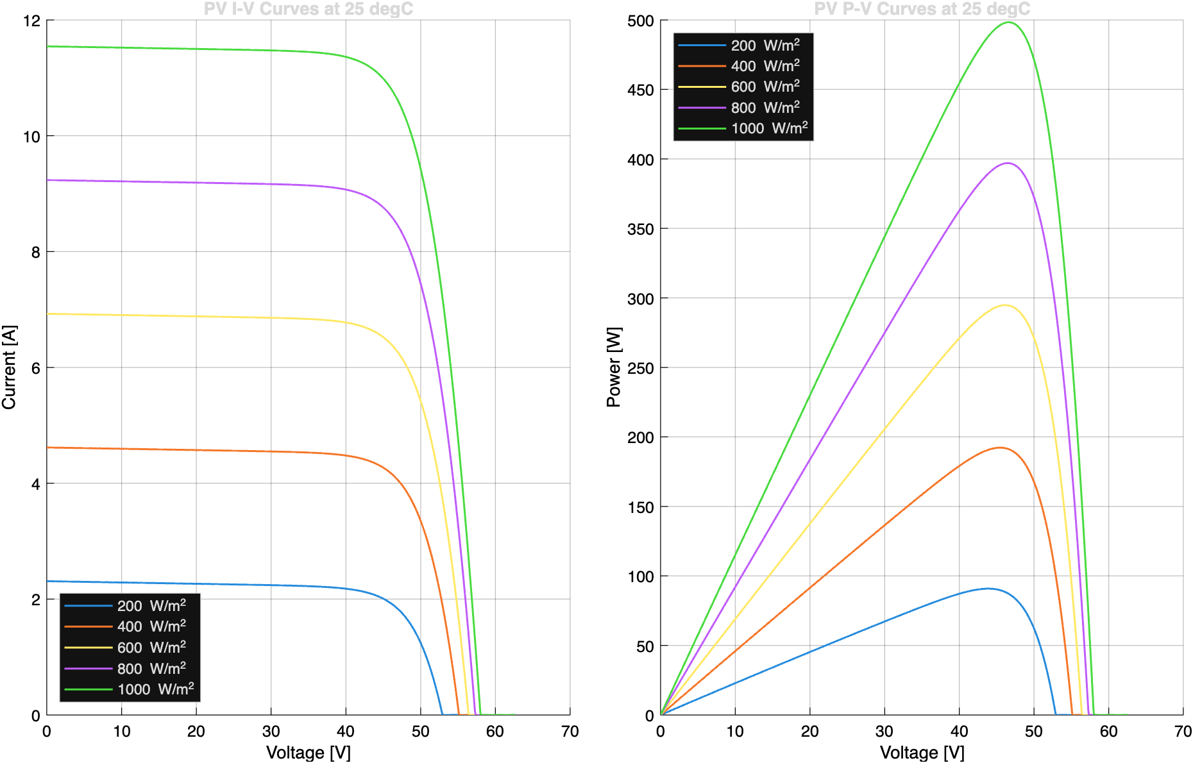
simulations/pv_model/results/pv_irradiance_curves.png
