HemangGadhvi04/48v-microgrid/simulations/system/results/solar_grid_current_and_duties.png

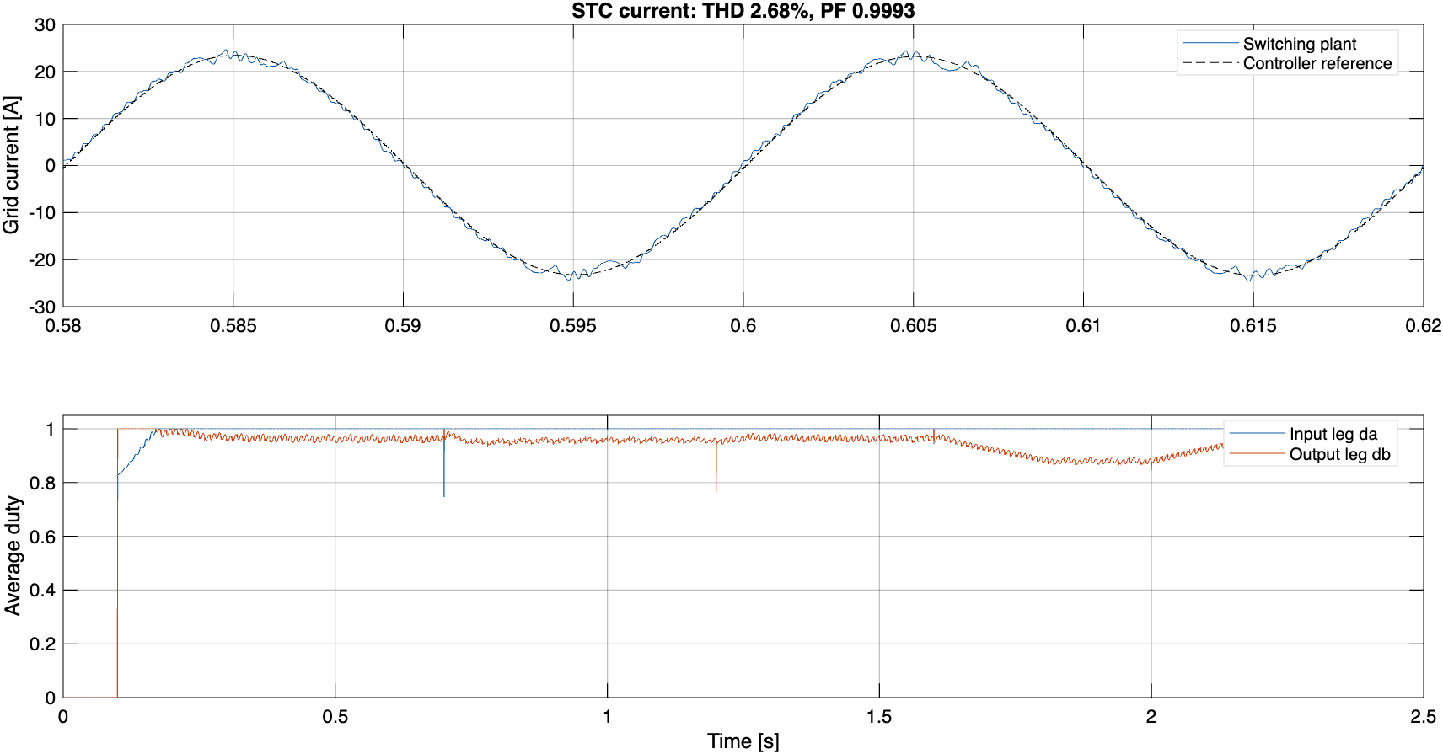
simulations/system/results/solar_grid_current_and_duties.png
