HemangGadhvi04/48v-microgrid/simulations/system/results/solar_grid_validation.png

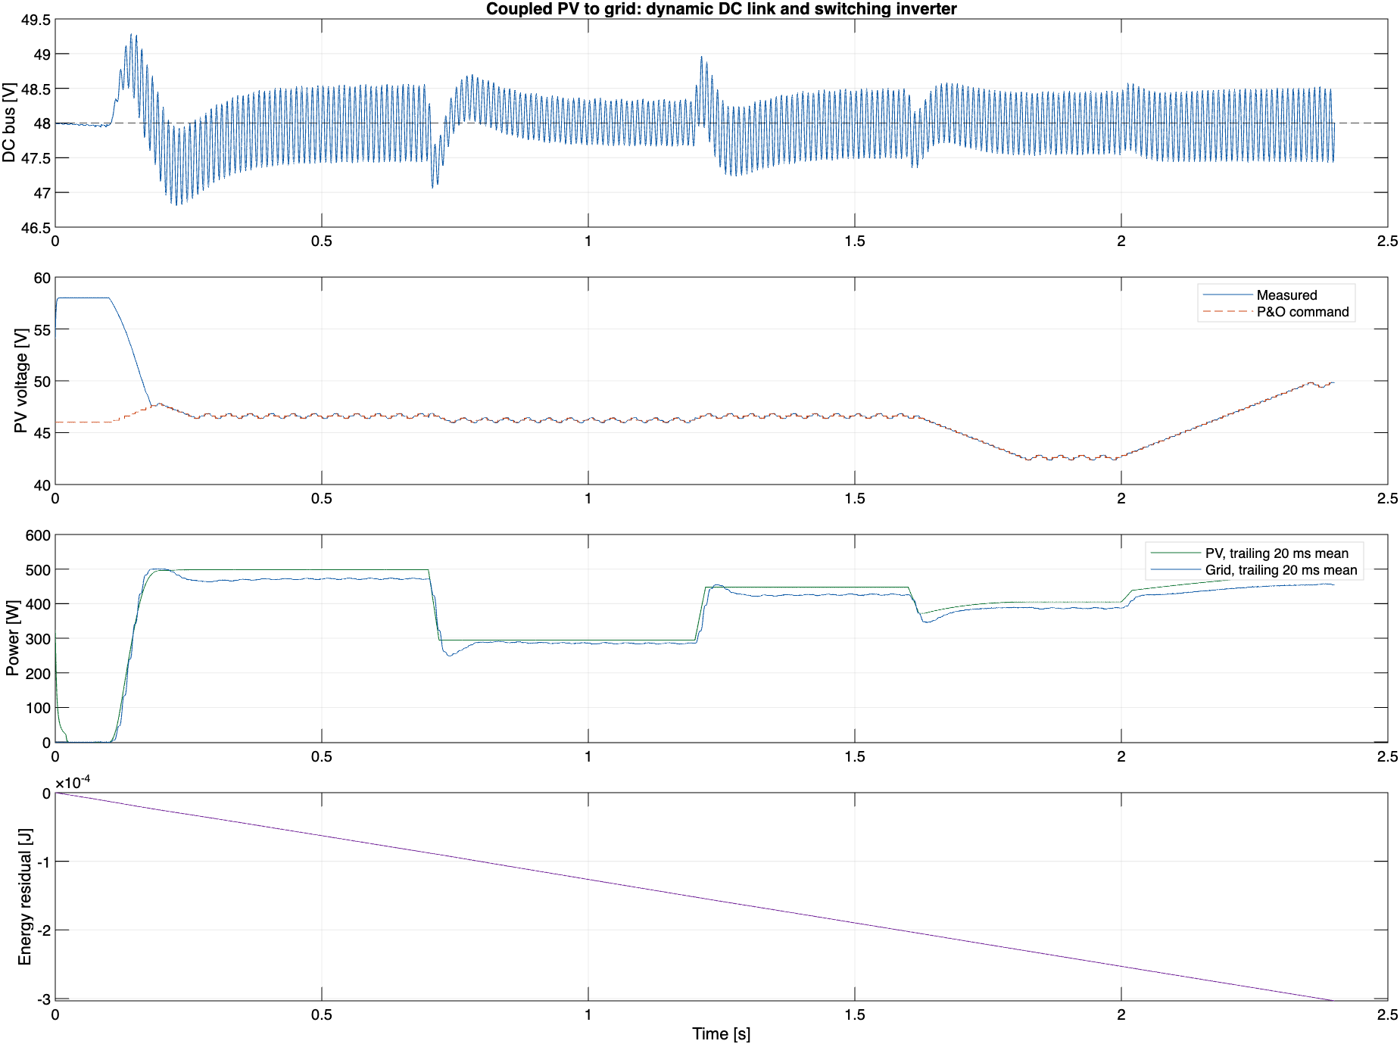
simulations/system/results/solar_grid_validation.png
