HemangGadhvi04/48v-microgrid/(list of files, drawings)

Other design files:
hardware/pcb_constraints.json
hardware/results/pcb_constraint_metrics.json
