HemangGadhvi04/48v-microgrid/hardware/kicad/microgrid_48v.kicad_sch

## KiCad design hardware/kicad/microgrid_48v.kicad_sch (2026-09-12)

Schematic: microgrid_48v.kicad_sch

Parts:
C165: 100 nF center-reference filter; C_0603_1608Metric_Pad1.08x0.95mm_HandSolder
CB1, CB2, CB3, CB4: 100nF 50V C0G; C_1206_3216Metric_Pad1.33x1.80mm_HandSolder
CBULK6, CBULK7, CBULK8: 100nF 50V C0G; C_1206_3216Metric_Pad1.33x1.80mm_HandSolder
CDC: 3x ALS31A103KE100
CF: C4AQUBW5200A3MJ 20uF
CFDC: 4.7 nF ADC charge-bucket capacitor; C_0603_1608Metric_Pad1.08x0.95mm_HandSolder
CFPV: 4.7 nF ADC charge-bucket capacitor; C_0603_1608Metric_Pad1.08x0.95mm_HandSolder
CFTEMP: 4.7 nF ADC charge-bucket capacitor; C_0603_1608Metric_Pad1.08x0.95mm_HandSolder
CFU14, CFU15: 4.7 nF ADC charge-bucket capacitor; C_0603_1608Metric_Pad1.08x0.95mm_HandSolder
CIN: Input capacitor positive
CISO1410: 100 nF isolated RS-485 bypass; C_0603_1608Metric_Pad1.08x0.95mm_HandSolder
CREF: 100 nF live-zero filter; C_0603_1608Metric_Pad1.08x0.95mm_HandSolder
CU9, CU10, CU14, CU15: 100 nF local bypass; C_0603_1608Metric_Pad1.08x0.95mm_HandSolder
CU11DCH1N, CU11HLO1N, CU11VDD1N, CU12DCH1N, CU12HLO1N, CU12VDD1N: 1 nF AMC3330 bypass; C_0603_1608Metric_Pad1.08x0.95mm_HandSolder
CU11DCH1U, CU11VDD1U, CU12DCH1U, CU12VDD1U: 1 uF AMC3330 bypass; C_0603_1608Metric_Pad1.08x0.95mm_HandSolder
CU11DCL, CU11HLO100N, CU12DCL, CU12HLO100N: 100 nF AMC3330 bypass; C_0603_1608Metric_Pad1.08x0.95mm_HandSolder
CU11IN, CU12IN: 1 nF isolated input filter; C_0603_1608Metric_Pad1.08x0.95mm_HandSolder
CU13: 100 nF TMP235 bypass; C_0603_1608Metric_Pad1.08x0.95mm_HandSolder
CUREF: 100 nF UREF bypass; C_0603_1608Metric_Pad1.08x0.95mm_HandSolder
CUREF2: 100 nF UREF2 bypass; C_0603_1608Metric_Pad1.08x0.95mm_HandSolder
CVOC6, CVOC7, CVOC8: 10 uF threshold stabilizer; C_1206_3216Metric_Pad1.33x1.80mm_HandSolder
CVS6, CVS7, CVS8: 100 nF local supply bypass; C_0603_1608Metric_Pad1.08x0.95mm_HandSolder
DK1: MURS120T3G; D_SMA
DKAC: MURS120T3G; D_SMA
DKPRE: MURS120T3G; D_SMA
F1: JLLN030.T 30A
FBA: Analog rail ferrite input; L_0603_1608Metric_Pad1.08x0.95mm_HandSolder
JAC: Isolated grid emulator line
JBIAS: Gate-driver bias input
JCOM: External RS485 A
JCTRL: C2000 PWM output
JDC: External battery or DC source
JPV: PV source positive
K1: Albright SW80B
KAC: G9KA-1A1B-E DC12
KPRE: Precharge relay input
L1: 150uH / 2x E65 / 19T
L2: 75uH / 1x E65 / 19T
LDC: 500uH / 3x E65 / 28T
NTAGND: Analog/digital ground net tie; NetTie-2_SMD_Pad0.5mm
Q1, Q2, Q3, Q4, Q5, Q6, Q7, Q8: CSD19536KCS; TO-220-3_Vertical
QK1: PMV37ENEA; SOT-23
QKAC: PMV37ENEA; SOT-23
QKPRE: PMV37ENEA; SOT-23
R165H: 10.0 kohm center-reference upper; R_0603_1608Metric_Pad0.98x0.95mm_HandSolder
R165L: 10.0 kohm center-reference lower; R_0603_1608Metric_Pad0.98x0.95mm_HandSolder
RD: HSC100R56J 0R56
RDCH1: 100 kohm divider upper 1; R_1206_3216Metric_Pad1.42x1.75mm_HandSolder
RDCH2: 100 kohm divider upper 2; R_1206_3216Metric_Pad1.42x1.75mm_HandSolder
RDCL: 10.0 kohm divider lower; R_0603_1608Metric_Pad0.98x0.95mm_HandSolder
RFDC: 1.00 kohm ADC isolation resistor; R_0603_1608Metric_Pad0.98x0.95mm_HandSolder
RFPV: 1.00 kohm ADC isolation resistor; R_0603_1608Metric_Pad0.98x0.95mm_HandSolder
RFTEMP: 1.00 kohm ADC isolation resistor; R_0603_1608Metric_Pad0.98x0.95mm_HandSolder
RFU14, RFU15: 1.00 kohm ADC isolation resistor; R_0603_1608Metric_Pad0.98x0.95mm_HandSolder
RG1, RG2, RG3, RG4, RG5, RG6, RG7, RG8: 5R-15R tuning footprint; R_0805_2012Metric_Pad1.20x1.40mm_HandSolder
RGS1, RGS2, RGS3, RGS4, RGS5, RGS6, RGS7, RGS8: 5R-15R tuning footprint; R_0805_2012Metric_Pad1.20x1.40mm_HandSolder
RPRE: HSC10047RJ 47R
RPVH1: 100 kohm divider upper 1; R_1206_3216Metric_Pad1.42x1.75mm_HandSolder
RPVH2: 100 kohm divider upper 2; R_1206_3216Metric_Pad1.42x1.75mm_HandSolder
RPVL: 10.0 kohm divider lower; R_0603_1608Metric_Pad0.98x0.95mm_HandSolder
RREFH: 30.4 kohm live-zero divider upper; R_0603_1608Metric_Pad0.98x0.95mm_HandSolder
RREFL: 1.00 kohm live-zero divider lower; R_0603_1608Metric_Pad0.98x0.95mm_HandSolder
RU11H1, RU12H1: 249 kohm isolation divider upper 1; R_1206_3216Metric_Pad1.42x1.75mm_HandSolder
RU11H2, RU12H2: 249 kohm isolation divider upper 2; R_1206_3216Metric_Pad1.42x1.75mm_HandSolder
RU11L, RU12L: 10.0 kohm isolation divider shunt; R_0603_1608Metric_Pad0.98x0.95mm_HandSolder
RU14FB, RU15FB: 15.0 kohm feedback; R_0603_1608Metric_Pad0.98x0.95mm_HandSolder
RU14INN, RU14INP, RU15INN, RU15INP: 20.0 kohm difference input; R_0603_1608Metric_Pad0.98x0.95mm_HandSolder
RU14REF, RU15REF: 15.0 kohm reference leg; R_0603_1608Metric_Pad0.98x0.95mm_HandSolder
RVH6, RVH7, RVH8: VOC divider upper resistor 8.40 kohm; R_0603_1608Metric_Pad0.98x0.95mm_HandSolder
RVL6, RVL7, RVL8: VOC divider lower resistor 4.99 kohm; R_0603_1608Metric_Pad0.98x0.95mm_HandSolder
U1, U2, U3, U4: UCC27211AQDDARQ1; SOIC-8-1EP_3.9x4.9mm_P1.27mm_EP2.95x3.4mm
U6, U7, U8: TMCS1123B2AQDVGRQ1; DVG0010A_HV
U9, U10: OPA320AQDBVRQ1G4; SOT-23-5
U11, U12: AMC3330QDWERQ1 + OPA320; SOIC-16W_7.5x10.3mm_P1.27mm
U13: TMP235; SOT-23
U14, U15: AMC3330 ADC driver; SOT-23-5
UBIAS: Gate-bias monitor input
UEN1, UEN2, UEN3, UEN4, UEN5, UEN6, UEN7, UEN8: PWM safety AND channel
UREF: 105 mV reference buffer; SOT-23-5
UREF2: 1.65 V center-reference buffer; SOT-23-5
URS485: ISO1410
UTRIP: SN74HCS02-Q1

Connections:
3V3: FBA.2, JBIAS.4, JCTRL.PWM1A, URS485.A
3V3_A: CBULK6.2, CBULK7.2, CBULK8.2, CU9.2, CU10.2, CU11VDD1N.2, CU11VDD1U.2, CU12VDD1N.2, CU12VDD1U.2, CU13.2, CU14.2, CU15.2, CUREF.2, CUREF2.2, CVS6.2, CVS7.2, CVS8.2, FBA.1, R165H.2, RREFH.2, U6.3 (GND), U7.3 (GND), U8.3 (GND), U9.IN-, U10.IN-, U11.HLDO_OUT, U12.HLDO_OUT, U13.OUT, U14.IN-, U15.IN-, UREF.IN-, UREF2.IN-
5V_ISO: CISO1410.2, JBIAS.5, URS485.DI
AC_INV: CF.2, L1.1, L2.2, RU11H1.2
AC_PCC: KAC.COIL-, U8.4 (ALERT)
AC_RETURN: CB4.1, CU11DCH1N.1, CU11DCH1U.1, CU11HLO1N.1, CU11HLO100N.1, CU11IN.1, CU12DCH1N.1, CU12DCH1U.1, CU12HLO1N.1, CU12HLO100N.1, CU12IN.1, JAC.1, Q7.S, Q8.G, RD.1, RGS7.1, RU11L.1, RU12L.1, U4.8 (LO), U11.DCDC_GND, U11.GND, U11.OUTN, U12.DCDC_GND, U12.GND, U12.OUTN
ADC_GRID_I: JCTRL.ADC_GRID_I, U8.9 (VOC)
ADC_GRID_V: CFU14.2, JCTRL.TRIP_LATCH_N, RFU14.1
ADC_IL_DC: JCTRL.ESTOP_N, U7.9 (VOC)
ADC_PV_I: JCTRL.PRECHARGE_CMD, U6.9 (VOC)
ADC_PV_V: CFPV.2, JCTRL.GRID_BREAKER_CMD, RFPV.1
ADC_TEMP: CFTEMP.2, JCTRL.ADC_UTILITY_V, RFTEMP.1
ADC_UTILITY_V: CFU15.2, JCTRL.ADC_TEMP, RFU15.1
ADC_VDC: CFDC.2, JCTRL.MAIN_CONTACTOR_CMD, RFDC.1
AFE_DIAG_N: U11.HLDO_IN, U12.HLDO_IN, UTRIP.IN1_N
AGND: C165.1, CBULK6.1, CBULK7.1, CBULK8.1, CFDC.1, CFPV.1, CFTEMP.1, CFU14.1, CFU15.1, CREF.1, CU9.1, CU10.1, CU11DCL.1, CU11VDD1N.1, CU11VDD1U.1, CU12DCL.1, CU12VDD1N.1, CU12VDD1U.1, CU13.1, CU14.1, CU15.1, CUREF.1, CUREF2.1, CVOC6.1, CVOC7.1, CVOC8.1, CVS6.1, CVS7.1, CVS8.1, NTAGND.1, R165L.1, RREFL.1, RVL6.1, RVL7.1, RVL8.1, U6.8 (VS), U7.8 (VS), U8.8 (VS), U9.IN+, U10.IN+, U11.DCDC_HGND, U11.HGND, U12.DCDC_HGND, U12.HGND, U13.SENSE, U14.IN+, U15.IN+, UREF.IN+, UREF2.IN+
BIAS_POWER_GOOD: JCTRL.PWM4A, UBIAS.OUT, UEN1.ARM, UEN2.ARM, UEN3.ARM, UEN4.ARM, UEN5.ARM, UEN6.ARM, UEN7.ARM, UEN8.ARM
BOOT1+: CB1.2, U1.5 (HI)
BOOT2+: CB2.2, U2.5 (HI)
BOOT3+: CB3.2, U3.5 (HI)
BOOT4+: CB4.2, U4.5 (HI)
CF_DAMP: CF.1, RD.2
COM_GND_ISO: CISO1410.1, JCOM.1, URS485.RO
DC48+: CDC.2, K1.COIL+, Q3.G, Q5.G, Q7.G, RDCH1.2, RPRE.1
DC_BUF: RFDC.2, U10.OUT, U10.VS
DC_DIV: RDCH2.1, RDCL.2, U10.GND
DC_DIV_MID: RDCH1.1, RDCH2.2
DC_SOURCE+: JDC.2, K1.COIL-, KPRE.COIL-
DGND: JBIAS.2, JCTRL.PWM2A, NTAGND.2, URS485.DE
DRV_Q1: RG1.2, U1.1 (VDD)
DRV_Q2: RG2.2, U1.4 (HS)
DRV_Q3: RG3.2, U2.1 (VDD)
DRV_Q4: RG4.2, U2.4 (HS)
DRV_Q5: RG5.2, U3.1 (VDD)
DRV_Q6: RG6.2, U3.4 (HS)
DRV_Q7: RG7.2, U4.1 (VDD)
DRV_Q8: RG8.2, U4.4 (HS)
ESTOP_N: JCTRL.ADC_IL_DC, UEN1.TRIP_N, UEN2.TRIP_N, UEN3.TRIP_N, UEN4.TRIP_N, UEN5.TRIP_N, UEN6.TRIP_N, UEN7.TRIP_N, UEN8.TRIP_N, UTRIP.IN4_N
GATE_Q1: Q1.D, RG1.1, RGS1.2
GATE_Q2: Q2.D, RG2.1, RGS2.2
GATE_Q3: Q3.D, RG3.1, RGS3.2
GATE_Q4: Q4.D, RG4.1, RGS4.2
GATE_Q5: Q5.D, RG5.1, RGS5.2
GATE_Q6: Q6.D, RG6.1, RGS6.2
GATE_Q7: Q7.D, RG7.1, RGS7.2
GATE_Q8: Q8.D, RG8.1, RGS8.2
GD12V: JBIAS.6, U1.3 (HO), U2.3 (HO), U3.3 (HO), U4.3 (HO), UBIAS.GND
GRID_BREAKER_CMD: JCTRL.ADC_PV_V, QKAC.D
GRID_COIL_LOW: DKAC.K, KAC.COM, QKAC.G
HEATSINK: U13.GND
L2_RAW: L2.1, U8.10 (NC)
LDC_RAW: LDC.1, U7.10 (NC)
MAIN_COIL_LOW: DK1.K, K1.COM, QK1.G
MAIN_CONTACTOR_CMD: JCTRL.ADC_VDC, QK1.D
OC_DC_N: U7.5 (VREF), UTRIP.DIAG_N
OC_GRID_N: U8.5 (VREF), UTRIP.OUT_N
OC_PV_N: U6.5 (VREF), UTRIP.AFE_DIAG_N
PGND: CDC.1, CIN.1, JBIAS.3, JCTRL.PWM1B, JDC.1, JPV.1, Q2.S, Q4.S, Q6.S, Q8.S, QK1.S, QKAC.S, QKPRE.S, RGS2.1, RGS4.1, RGS6.1, RGS8.1, U1.6 (LI), U2.6 (LI), U3.6 (LI), U4.6 (LI), UBIAS.IN
PRECHARGE_CMD: JCTRL.ADC_PV_I, QKPRE.D
PRECHARGE_COIL_LOW: DKPRE.K, KPRE.COM, QKPRE.G
PRECHARGE_IN: KPRE.COIL+, RPRE.2
PV_BUF: RFPV.2, U9.OUT, U9.VS
PV_DIV: RPVH2.1, RPVL.2, U9.GND
PV_DIV_MID: RPVH1.1, RPVH2.2
PV_FUSED+: CIN.2, F1.1, U6.10 (NC)
PV_IN+: F1.2, JPV.2
PV_SENSED+: Q1.G, RPVH1.2, U6.4 (ALERT)
PWM1A: U1.2 (HB), UEN1.PWM
PWM1A_RAW: JCTRL.3V3, UEN1.OUT
PWM1B: U1.7 (VSS), UEN2.PWM
PWM1B_RAW: JCTRL.PGND_SENSE, UEN2.OUT
PWM2A: U2.2 (HB), UEN3.PWM
PWM2A_RAW: JCTRL.DGND, UEN3.OUT
PWM2B: U2.7 (VSS), UEN4.PWM
PWM2B_RAW: JCTRL.RS485_DE, UEN4.OUT
PWM3A: U3.2 (HB), UEN5.PWM
PWM3A_RAW: JCTRL.RS485_RX, UEN5.OUT
PWM3B: U3.7 (VSS), UEN6.PWM
PWM3B_RAW: JCTRL.RS485_TX, UEN6.OUT
PWM4A: U4.2 (HB), UEN7.PWM
PWM4A_RAW: JCTRL.BIAS_POWER_GOOD, UEN7.OUT
PWM4B: U4.7 (VSS), UEN8.PWM
PWM4B_RAW: JCTRL.PWM_ARM, UEN8.OUT
PWM_ARM: JCTRL.PWM4B, UEN1.BIAS_OK, UEN2.BIAS_OK, UEN3.BIAS_OK, UEN4.BIAS_OK, UEN5.BIAS_OK, UEN6.BIAS_OK, UEN7.BIAS_OK, UEN8.BIAS_OK
RELAY12V: DK1.A, DKAC.A, DKPRE.A, JBIAS.1, K1.NO, KAC.NO, KPRE.NO
RS485_A: JCOM.3, URS485.VCC
RS485_B: JCOM.2, URS485.B
RS485_DE: JCTRL.PWM2B, URS485.GND
RS485_RX: JCTRL.PWM3A, URS485.GND_ISO
RS485_TX: JCTRL.PWM3B, URS485.VCC_ISO
SENSOR_ALERT_N: U6.2 (IP-), U7.2 (IP-), U8.2 (IP-), UTRIP.IN2_N
SW_A: CB3.1, L1.2, Q5.S, Q6.G, RGS5.1, U3.8 (LO)
SW_DC: CB2.1, Q3.S, Q4.G, RGS3.1, U2.8 (LO), U7.4 (ALERT)
SW_PV: CB1.1, LDC.2, Q1.S, Q2.G, RGS1.1, U1.8 (LO)
TEMP_RAW: RFTEMP.2, U13.VS
TRIP_LATCH_N: JCTRL.ADC_GRID_V, UEN1.ESTOP_N, UEN2.ESTOP_N, UEN3.ESTOP_N, UEN4.ESTOP_N, UEN5.ESTOP_N, UEN6.ESTOP_N, UEN7.ESTOP_N, UEN8.ESTOP_N, UTRIP.IN3_N
U11_DCDC_HI: CU11DCH1N.2, CU11DCH1U.2, U11.DCDC_IN, U11.DIAG
U11_DCDC_LO: CU11DCL.2, U11.DCDC_OUT, U11.NC
U11_DIV_MID: RU11H1.1, RU11H2.2
U11_HLDO: CU11HLO1N.2, CU11HLO100N.2, U11.VDD
U11_OUTN: RU14INN.2, U11.INN
U11_OUTP: RU14INP.2, U11.INP
U11_VSENSE: CU11IN.2, RU11H2.1, RU11L.2, U11.OUTP
U12_DCDC_HI: CU12DCH1N.2, CU12DCH1U.2, U12.DCDC_IN, U12.DIAG
U12_DCDC_LO: CU12DCL.2, U12.DCDC_OUT, U12.NC
U12_DIV_MID: RU12H1.1, RU12H2.2
U12_HLDO: CU12HLO1N.2, CU12HLO100N.2, U12.VDD
U12_OUTN: RU15INN.2, U12.INN
U12_OUTP: RU15INP.2, U12.INP
U12_VSENSE: CU12IN.2, RU12H2.1, RU12L.2, U12.OUTP
U14_NN: RU14FB.1, RU14INN.1, U14.VS
U14_NP: RU14INP.1, RU14REF.1, U14.GND
U14_OUT: RFU14.2, RU14FB.2, U14.OUT
U15_NN: RU15FB.1, RU15INN.1, U15.VS
U15_NP: RU15INP.1, RU15REF.1, U15.GND
U15_OUT: RFU15.2, RU15FB.2, U15.OUT
UTILITY_AC: JAC.2, KAC.COIL+, RU12H1.2
VOC_U6: CVOC6.2, RVH6.1, RVL6.2, U6.6 (VOUT)
VOC_U7: CVOC7.2, RVH7.1, RVL7.2, U7.6 (VOUT)
VOC_U8: CVOC8.2, RVH8.1, RVL8.2, U8.6 (VOUT)
VREF105: RDCL.1, RPVL.1, UREF.OUT, UREF.VS
VREF105_RAW: CREF.2, RREFH.1, RREFL.2, UREF.GND
VREF165: RU14REF.2, RU15REF.2, UREF2.OUT, UREF2.VS
VREF165_RAW: C165.2, R165H.1, R165L.2, UREF2.GND
VREF_U6: RVH6.2, U6.7 (OC)
VREF_U7: RVH7.2, U7.7 (OC)
VREF_U8: RVH8.2, U8.7 (OC)
