HemangGadhvi04/48v-microgrid/(commit log)

2026-09-06 feat: initialize 48V Microgrid Research Platform repository and Phase 1 simulation scaffolding
    [waveform_data_sample.csv]
2026-09-11 feat: complete Phase 1-4 microgrid simulations, hardware sizing, firmware core, and telemetry gateway
    [closed_loop_harmonics.csv, connectivity_netlist.csv, grid_following_harmonics.csv, lcl_frequency_response.csv, lcl_grid_harmonics.csv, magnetics_requirements.csv, microgrid_48v.kicad_sch, open_loop_bridge_spectrum.csv]
2026-09-11 feat: formalize execution gates and close magnetics sizing screen
    [microgrid_48v.kicad_sch]
2026-09-11 test: validate all C2000 Driverlib symbols upstream
2026-09-11 feat: define exact analog measurement front ends
    [microgrid_48v.kicad_sch, reference_bom.csv, sensing_channels.csv]
2026-09-11 docs: freeze isolated voltage amplifier support network
2026-09-11 feat: expand complete analog front ends in schematic
    [connectivity_netlist.csv, microgrid_48v.kicad_sch]
2026-09-11 feat: add electrical pin types for native ERC
    [microgrid_48v.kicad_sch]
2026-09-11 feat: assign frozen schematic footprints
    [microgrid_48v.kicad_sch]
2026-09-11 feat: assign reviewed signal-component footprints
    [microgrid_48v.kicad_sch]
2026-09-12 feat: complete C2000 Driverlib HAL, KiCad footprints, and Gate 2 design review
    [microgrid_48v.kicad_sch, reference_bom.csv]
