HemangGadhvi04/48v-microgrid/(notices)

Notices in the files:
README.md:
License: MIT
